jawal19/3D-printing-a-mechanical-device/Report/Images/Ramp/ramp_3.PNG

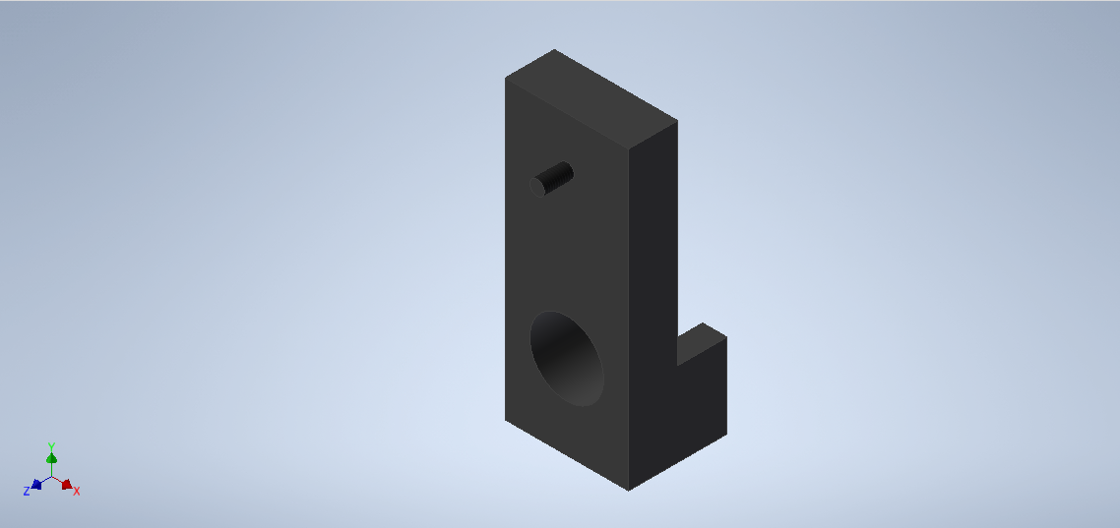
Report/Images/Ramp/ramp_3.PNG
