jawal19/3D-printing-a-mechanical-device/Report/Images/Ramp/ramp_1.PNG

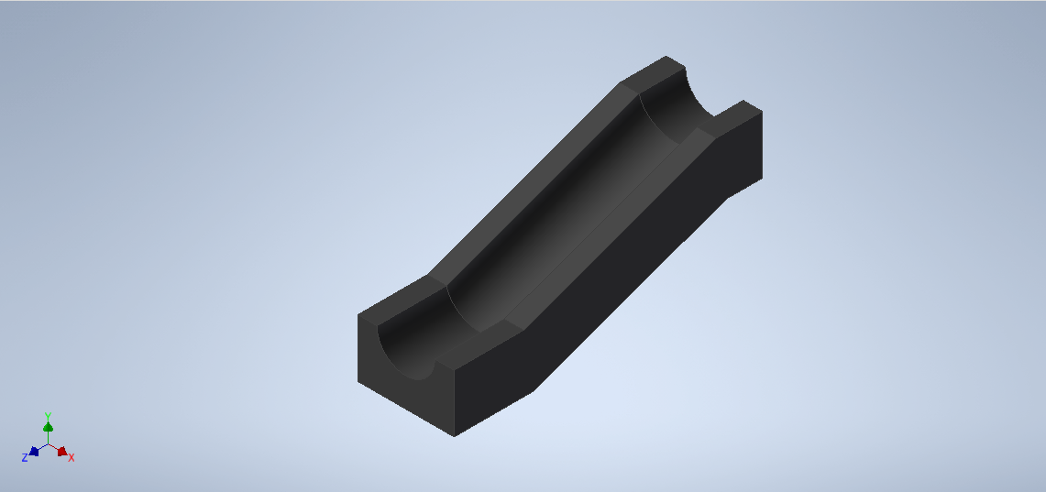
Report/Images/Ramp/ramp_1.PNG
