jawal19/3D-printing-a-mechanical-device/README.md

# Project-A
 Mechanical System transferring a steel ball
