jawal19/3D-printing-a-mechanical-device/Submision 1/Project A.pdf

# Project A

Jawal Trivedi & Nabeel Azafer

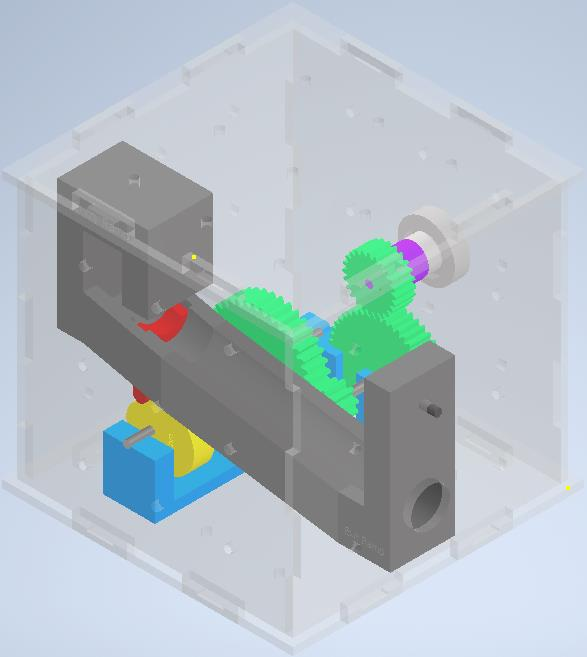
[picture p5: figure]

## Contents

Executive Summary | 3
Design Process | 3
Mechanism Specifications | 3
Shaft Rotational Speed | 3
Gear Ratio | 3
Bill of Materials | 3
Summary of Design Calculations | 6
Required Speed Output | 6
Compound Gear Train | 6
Summary of Analysis | 6
Dynamic Simulation 1 | 6
Dynamic Simulation 2 | 6
Summary of Prototype Manufacturing | 7
Justification of 3D Printing | 7
Design Decisions based on 3D Printing | 7
3D Printer Build Settings | 8
Print 1 | 8
Print 2 | 8
Print 3 | 8
Print 4 | 8
Decisions for Ease of Assembly | 8
Iterative Improvements | 8
Time Cost Analysis | 9
Conclusions | 9
Appendix | 10
Appendix A – Figures | 10
Appendix B – Calculations | 14
Appendix C – Statement of Contributions | 14
Appendix D – Tables | 15

## Executive Summary

Project A revolved around designing a mechanism with two mechanical elements which fits into a box of cubic volume 100mm³. The aim of the mechanisms is to transfer a steel ball of 9.5mm diameter from one end of the box to the other. The mechanical elements must convert an input rotation into the desired motion to drive the ball in exactly 5.0 seconds. Our team has iterated a solution which includes, support structures, a cam and follower mechanism and a compound gear train for the design problem (refer to Figure 5).

## Design Process

During the Project, our team mainly focused on the conceptual design and prototyping phases of the design process. The project was initialised with a close look at the specifications/requirements and creating a PDS. Thereafter we developed a product decomposition (refer to Figure 6) to break down the overall design problem. Referring to the decomposition, the next stage was to identify the two or more mechanical elements. We individually came up with two ideas each for the different combinations of elements and used those to develop a Pugh’s Matrix (refer to Table 3). Using this analysis tool, we decided on a cam & follower alongside a compound gear train. With a brief iteration back to the product decomposition, we discussed the type of support and collectively agreed that a ramp connecting the entry and exit holes would be best. Once the two elements and the support type were agreed on, we fixated on deciding the joining mechanisms. Initially we had thought of using the M3 series of nuts and bolts to fix our ramp, however later in the prototyping phase we made a judgement call and decided to use superglue. Similarly, in terms of joining the gears and shaft together we had planned to extrude the shaft out of the gear with a key, however, this was substituted by a steel rod and superglue during the prototyping phase.

## Mechanism Specifications

### Shaft Rotational Speed

The required shaft rotational speed is 60RPM. (Refer to Appendix B – Calculations for elaboration)

### Gear Ratio

The overall gear ratio of the compound gear train is 8:1. The ratio of each set of meshing gears is 1:2 and 1:4. (Refer to Appendix B – Calculations for elaboration)

### Bill of Materials

The Bill of Materials below excludes the parts provided by the University, e.g. the box sides and the driveshaft coupling.

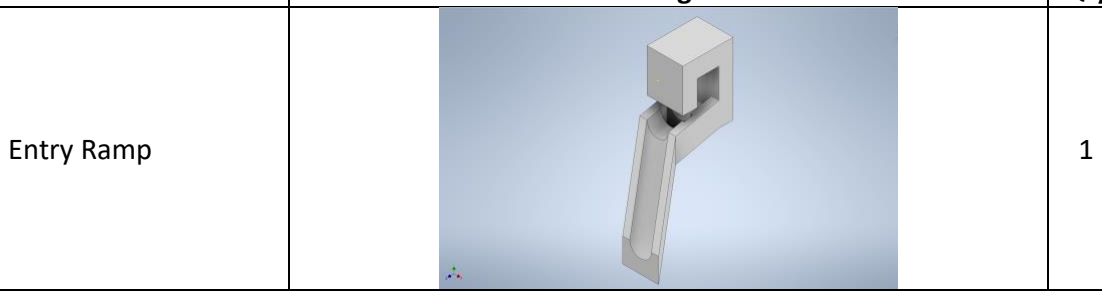
[picture p6: figure]
Entry Ramp

Part Name | Image | Qty

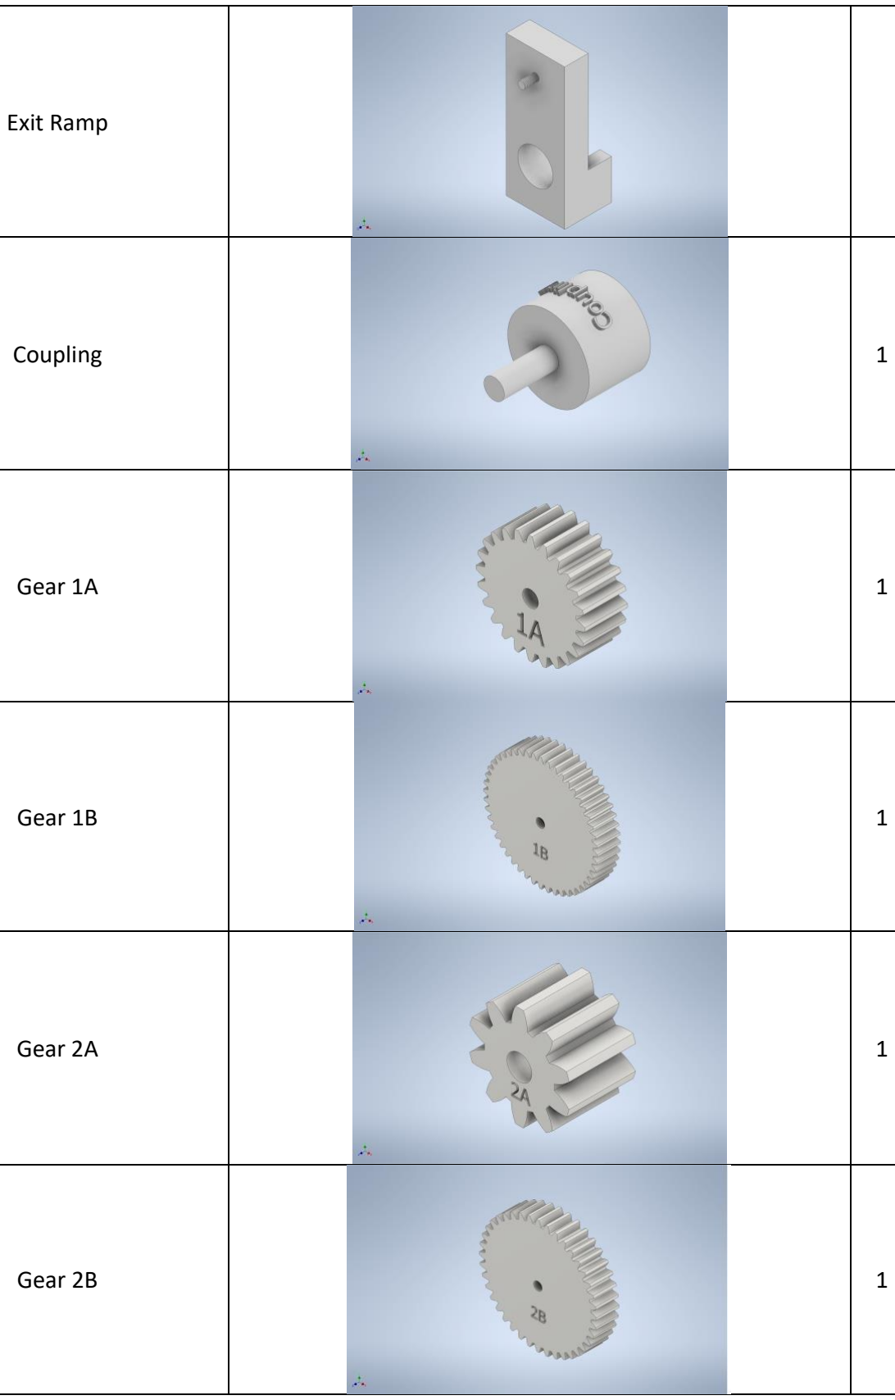
[picture p7: figure]
Exit Ramp; Coupling; Gear 1A; Gear 1B; Gear 2A; Gear 2B

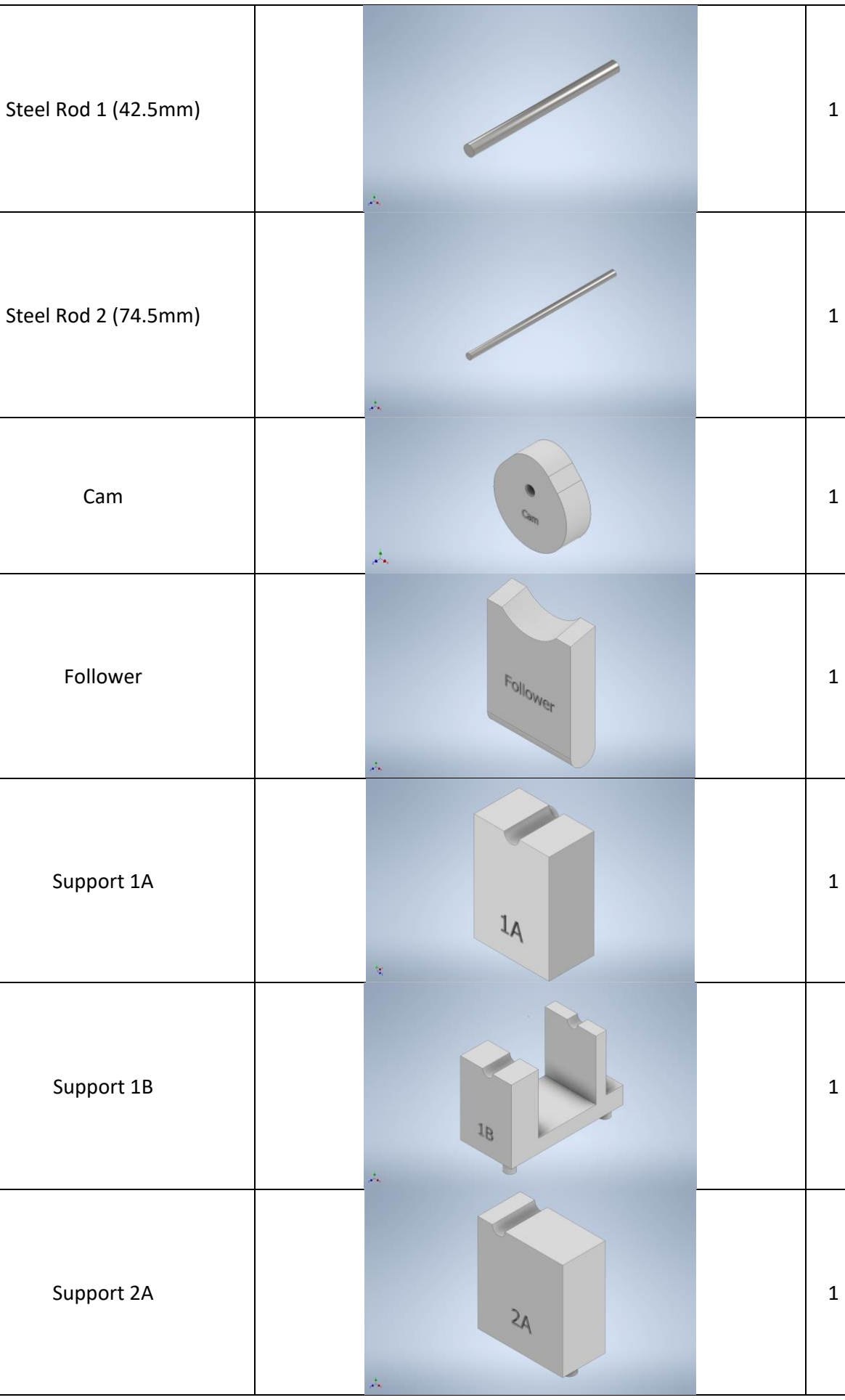
[picture p8: figure]
Steel Rod 1 (42.5mm); Steel Rod 2 (74.5mm); Cam; Follower; Support 1A; Support 1B; Support 2A

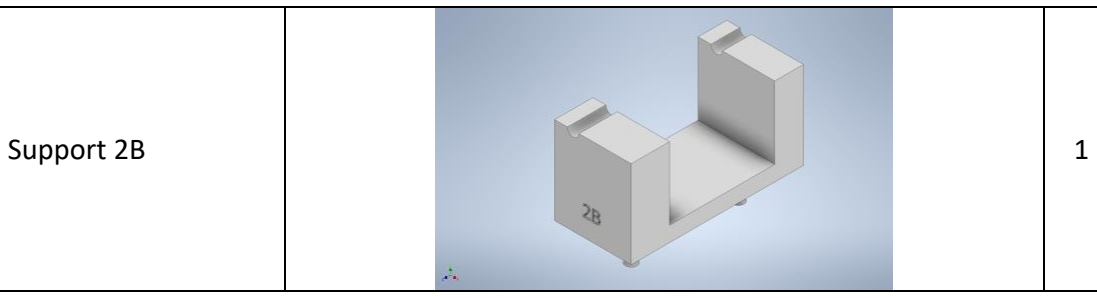
[picture p9: figure]
Support 2B

Table 1: Bill of Materials

## Summary of Design Calculations

### Required Speed Output

According to a dynamic simulation model (refer to Dynamic Simulation 1), it takes about, 0.3 seconds for the ball to come down the ramp. Therefore, the ball needs to be obstructed by the follower for about 4 seconds. If the dwell of the cam lasts for 180° and the input rotational speed is 60RPM, Calculation 1 shows the gear ratio comes to 8:1.

### Compound Gear Train

Calculation 2 shows the gear ration of each meshing gears in the compound gear train. If the overall ratio needs to be 8:1, then first set of meshing gears needs to have a ratio of 1:2, and the second set of meshing gears needs to have a ratio of 1:4.

## Summary of Analysis

### Dynamic Simulation 1

The first analysis was a dynamic simulation of the steel ball rolling down the ramp. This was carried out to extract the time taken for the ball to roll down the ramp. The simulation estimated around 0.3 seconds (refer to Figure 7). Figure 1 below shows the graph of the velocity of the ball (in mm/s) in the x-direction. As the ball moves in the negative x-direction the velocities shown are negative. From the analysis of the graph, our team decided to put the obstruction by follower when the velocity is relatively small so there won’t be too much deflection.

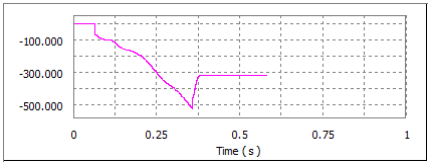
[picture p10: figure]

Figure 1: Graph of Velocity vs Time of ball in X-direction

### Dynamic Simulation 2

The second dynamic simulation was done to check whether our mechanism outputs the steel ball in the time predicted. The analysis showed that if the follower height was increased by 2mm, and the profile of the cam profile was reverted to the pear shape, the time taken is approximately 5.06 seconds which falls under the tolerance. Figure 2 below shows the coordinates of the ball in X (Blue), Y (Pink) and Z (Red) direction in mm, over time.

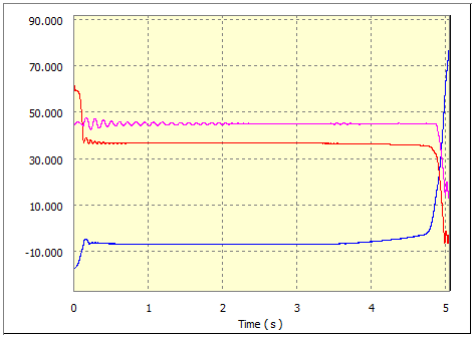
[picture p11: figure]

Figure 2: Graph of Coordinates in X,Y,Z-direction vs Time of the steel ball

## Summary of Prototype Manufacturing

### Justification of 3D Printing

Throughout this project we only used a 3D printer to print the parts. We decided against using a laser cutter because the only parts we could’ve laser cut were the gears due to the thickness limitations. Besides this, when we were up to the prototyping phase, we didn’t have enough time to use both, hence we only used the 3D printers throughout this project.

While using the 3D printers, we simultaneously printed our first two prints, and produced parts that were either incorrectly dimensioned (calculation error) or of poor quality (printer error). On our third attempt we were able to print the correct parts, however, during post-processing, we damaged the coupling to the drive shaft. Due to this and a few design changes after our analysis, we executed a fourth and final print.

### Design Decisions based on 3D Printing

A slot in the Entry Ramp was created for the follower to slide up and down in. This design decision was made knowing that we are 3D printing the part, otherwise it would have been too difficult to fabricate. We also decided not to have a roller on our follower as the curved edge from 3D printing would be able to compensate for it. The thickness of the parts created were purposely greater than 3mm, because of the limitations of the printers. Whilst designing the gears, the minimum pitch diameter our team considered was 10mm, again due to the fabrication limits of the 3D printer.

### 3D Printer Build Settings

Print 1
As we were inexperienced in 3D printing, we heavily relied on the guidelines provided. We used an Original Prusa Mini printer with a 0.4mm nozzle. We used 0.25mm layer height with variable layer height on adaptive at 0.5. We also added support material everywhere as we were uncomfortable deciding this manually. The build plate was arranged automatically according to the PrusaSlicer software (refer to Figure 8). The printer, however, was slightly faulty so Jonathan Stringer changed a few settings such as the nozzle temperature using the Expert mode in the software.

Print 2
The second print was also on an Original Prusa Mini (0.4mm nozzle. On this print however, we used a general layer height of 0.20mm for a better quality with adaptive in variable layer height with preference to quality (0.3). Again, we added supports everywhere as this print had an overhang used the arrange function to automatically arrange the parts onto the bed (refer to Figure 9).

Print 3
We were able to use an Original Prusa i3 MK2S (0.4mm nozzle) on our third attempt. The general layer height selected was 0.35mm, with variable layer height selected on adaptive at 0.5. Supports were added everywhere, and the arrange function was again used to automatically set the parts on the bed (refer to Figure 10).

Print 4
We used the Original Prusa i3 MK2S (0.4mm nozzle) in the final print. A general layer of 0.35mm was selected with variable layer height on at 0.5. Supports were added everywhere and the plate was arranged automatically (refer to Figure 11).

### Decisions for Ease of Assembly

Our original print had keys/keyways and a shaft extruded on; however, both were excluded from the final assembly. The keys/keyway were pointless due to the dimensional accuracy of the 3D Printers. We excluded the shaft extrusion because as we were snipping off the support material on the gears, we accidentally ripped of part of the shaft which would’ve been catastrophic if that happened during testing. In replacement of these two features we settled on using the 3mm steel shaft superglued to the gears and cam.

### Iterative Improvements

As shown in Figure 3 below the Ramp went through an iterative design process which improved its functionality over the process. The second iteration shows an input similar to a hook, this was added to account for a high input velocity of the ball, which made the design more robust. The combination of the first two designs is shown in the third iteration. The fourth and fifth iteration shows, a slot for the follower was implemented and the exit ramp improved such that it connects to the exit hole rather than hanging freely. The fifth image shows the entry and exit ramps in conjunction, which was used in the final assembly.

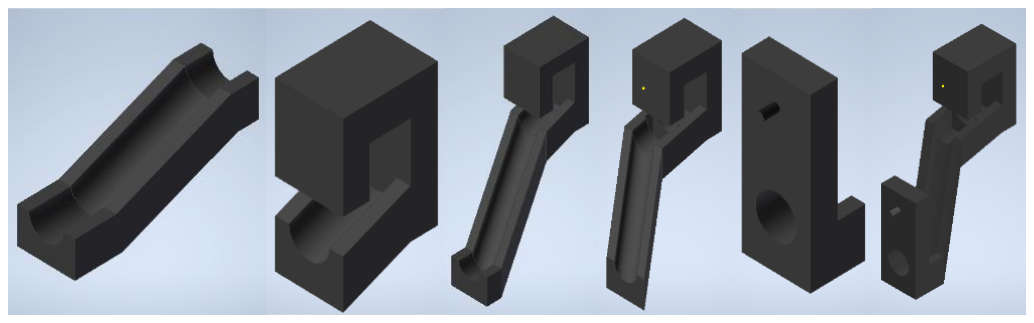
[picture p12: figure]

Figure 3: Design improvements of the Ramp

In Figure 4 the design improvements of the cam. The profile of the cam was changed in all successions. The second iteration the profile was changed from a snail shape to a pear shape as there was a significant drop, which would apply unnecessary force onto the shaft. The third iteration was created as there was limited space and the previous profile was obstructing part the ramp. A keyway was also added in this occurrence to drive the shaft more smoothly. The fourth succession was created because an unnecessary dwell and rise was noticed in the behaviour of the follower. The fifth iteration was created after the analysis showed that this pear-shaped profile achieves the closest time to 5.0 seconds. Therefore, the bump at the top of the third cam was levelled out the location of the input was changed to improve the previous instalment.

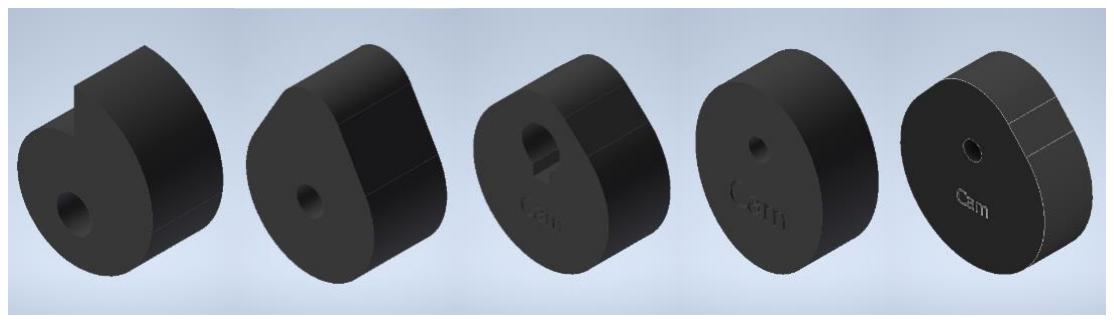
[picture p13: figure]

Figure 4: Deign improvements of the Cam

### Time Cost Analysis

Category | 3D Printing
Material | 105.39g at $50/kg $5.30
Energy | 7.6 hours & 50W at $0.2/kWh $0.077
Labour | ~2 hours @ $30/hr $60
Total Time | 9.6 hours (9hr 40min)
Total Cost | $65.40
Table 2: Time Cost Analysis

## Conclusions

Throughout Project A, we learned a lot about Prototype Manufacturing, more specifically using 3D Printing. The solution we derived included a ramp for the ball to roll down, a follower driven by a cam to obstruct and delay the ball, and a gear train to time and drive the cam. Alongside the main elements, we created support structures and couplings for the gear and input shaft respectively. To join the gears, we utilised the 3mm steel rod and superglue. The overall mechanism converts rotational motion by the input to linear motion produced by the follower. Using analysis tools such as dynamic simulation we were able to predict that our mechanism meets the required time of 5.0 seconds. Refer to Figure 12 to Figure 15 for a visual interpretation of our design.

## Appendix

### Appendix A – Figures

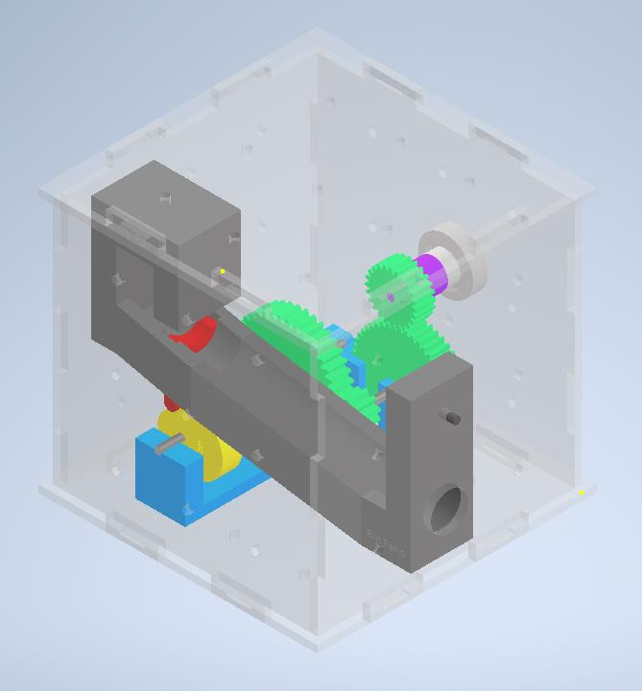
[picture p14: figure]

Figure 5: Final Assembly

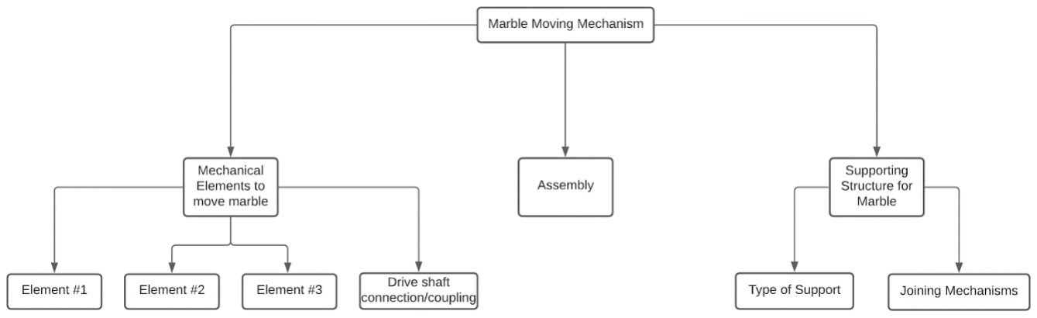
[picture p15: figure]

Figure 6: Product Decomposition

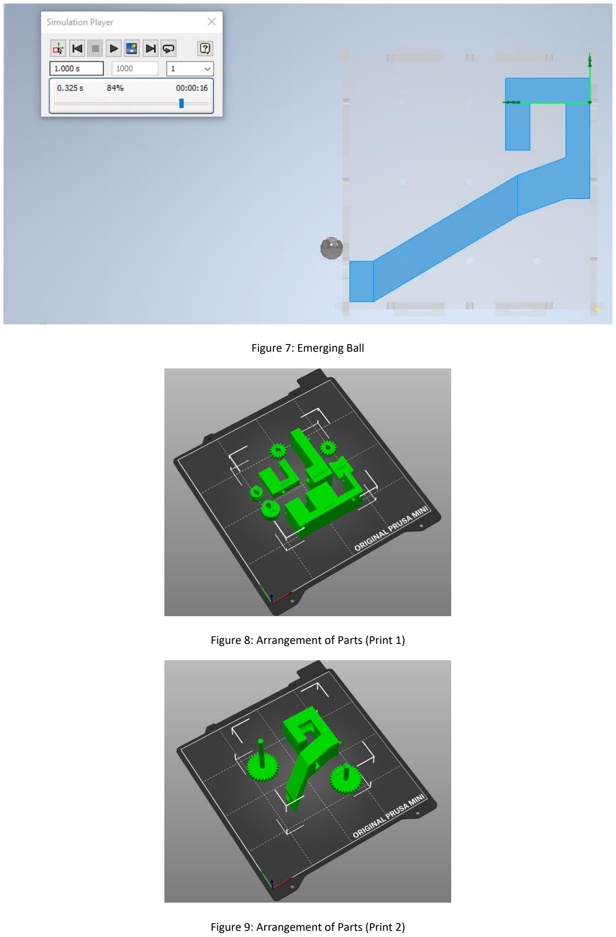
[picture p16: page 11]

Figure 7: Emerging Ball

Figure 8: Arrangement of Parts (Print 1)

Figure 9: Arrangement of Parts (Print 2)

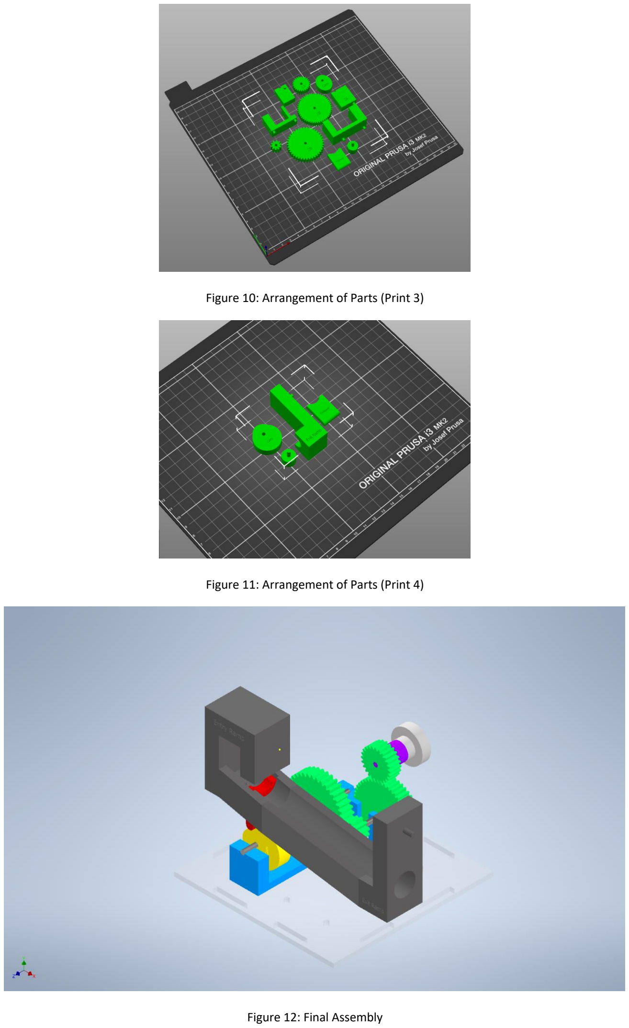
[picture p17: page 12]

Figure 10: Arrangement of Parts (Print 3)

Figure 11: Arrangement of Parts (Print 4)

Figure 12: Final Assembly

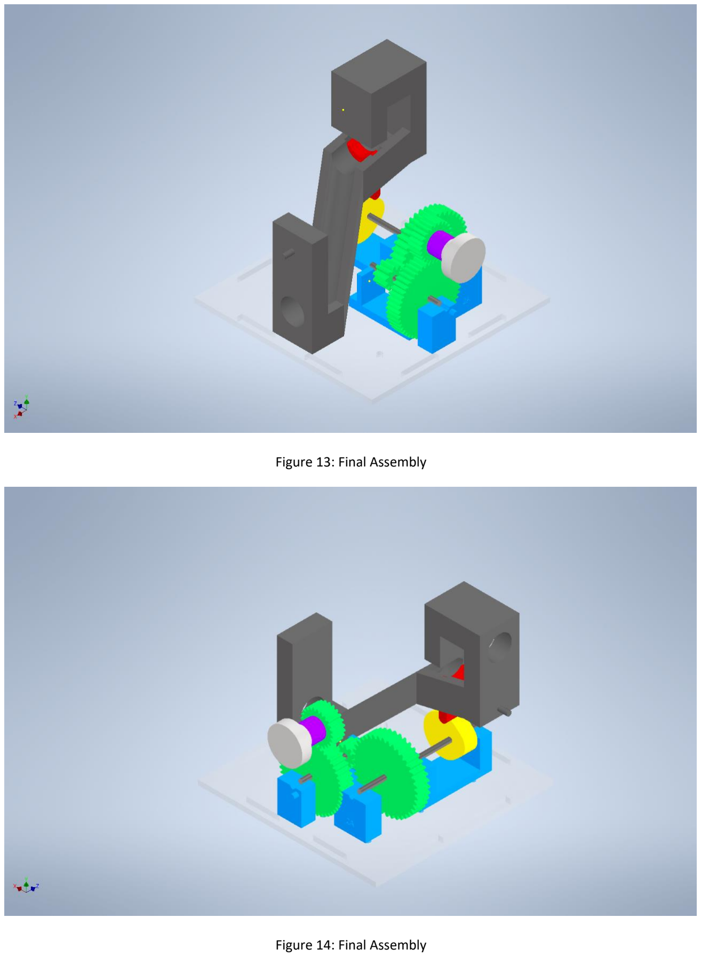
[picture p18: page 13]

Figure 13: Final Assembly

Figure 14: Final Assembly

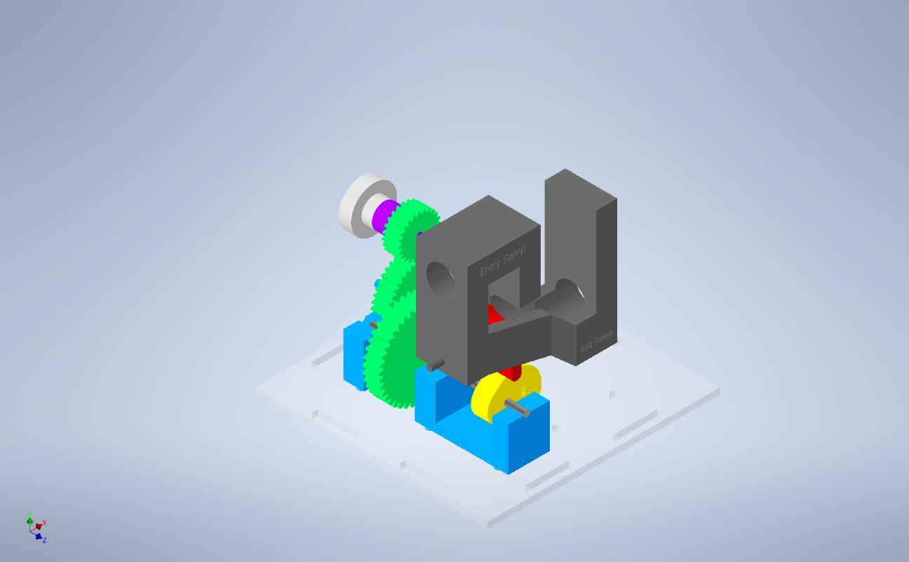
[picture p19: figure]

Figure 15: Final Assembly

### Appendix B – Calculations

180 deg
4 sec

=

45 deg
sec
∴

45 deg
sec

×

1 rev
360 deg ×

60 sec
1 min
= 7.5 RPM
So tℎe overall gear ratio will be 60: 7.5 or 8: 1

1

ωinput

ωoutput

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
### Appendix C – Statement of Contributions

Category | Jawal | Nabeel
PDS | 50% | 50%
Product Decomposition | 50% | 50%
Pugh’s Matrix | 50% | 50%
Calculations | 60% | 40%
CAD Model | 40% | 60%
Dynamic Simulation | 40% | 60%
3D Printing & Assembly | 50% | 50%

### Appendix D – Tables

Categories | Straight-line linkage with cam | Scooping sliding mechanism | Gear trains with cam | Gear Train with sliding crank
Accuracy | Can accurately move the marble vertically N/A | May not be able to accurately pick up the ball -VE | Could be precise once we have the correct timing on the cams EQUAL | Would be accurate as we just need to do the sliding crank calculations. EQUAL
Robustness | Since the cam element will block the ball variations in ball input velocity won’t have a major impact N/A | Differing ball input velocities may result in different outcomes -VE | Could be an issue with a high-velocity input of the ball -1 | Quite robust because, as the marble is inputted its motion instantly changes. +VE
Ease of Assembly | 4 bar linkage mechanism may be difficult to assemble, due to multiple joints N/A | Relatively simple assembly +VE | Cam mechanism could be complicated to assemble. +VE | The sliding crank would be difficult to assemble -VE
Ease of Manufacturing | Will likely have to 3d print joints individually which can take time N/A | Not many components to print, but the sliding mechanism will take time to print EQUAL | Many different components to print, so could take a while EQUAL | Not too complicated to print with a 3D printer. EQUAL
Design Simplicity | The cam element is simple, the linkage is slightly more complex N/A | The sliding element will likely be very complex to design and implement -VE | Quite a simple design as it only has two easy to understand mechanisms +VE | A complicated design due to the positioning of the two mechanical elements +VE
Number of Moving parts | Quite a few moving parts like joints, gears etc N/A | Only a few moving parts +VE | Various moving parts includes gear train and cams. Will also needs multiple bearings. +VE | Not that many moving parts, only gears, crank, conrod and slider. +VE

Overall | N/A

1

3

2

Table

3: Pugh’s Matrix
