jawal19/3D-printing-a-mechanical-device/Report/Images/Cam/Cam_1.PNG

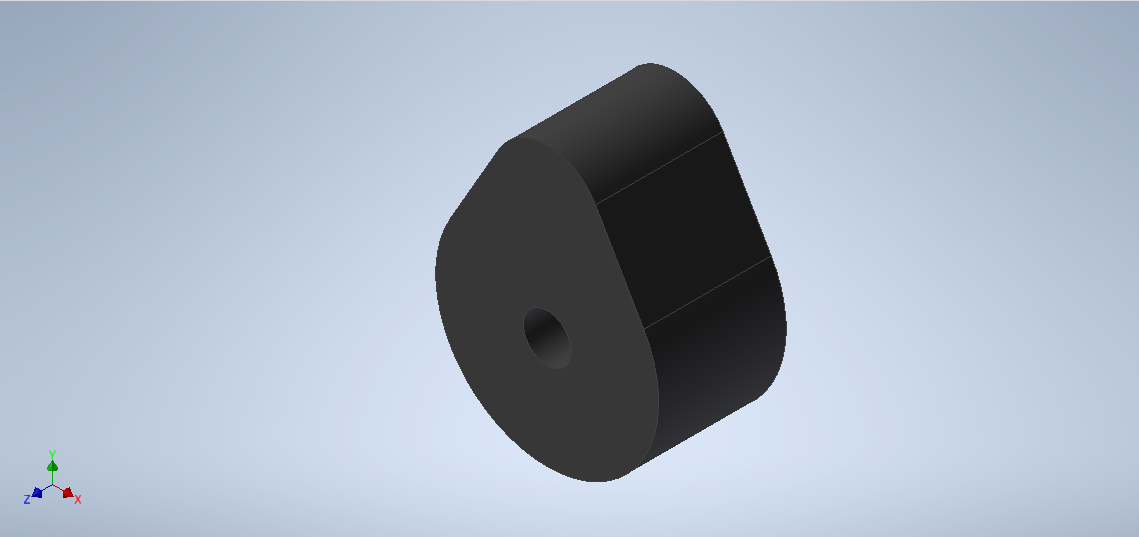
Report/Images/Cam/Cam_1.PNG
