jawal19/3D-printing-a-mechanical-device/Report/Images/Cam/Cam_3.PNG

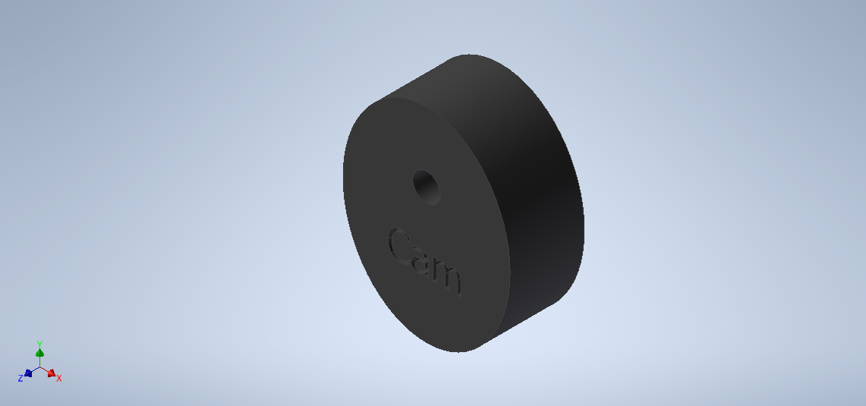
Report/Images/Cam/Cam_3.PNG
