jawal19/3D-printing-a-mechanical-device/Report/Images/Cam/Cam_4.PNG

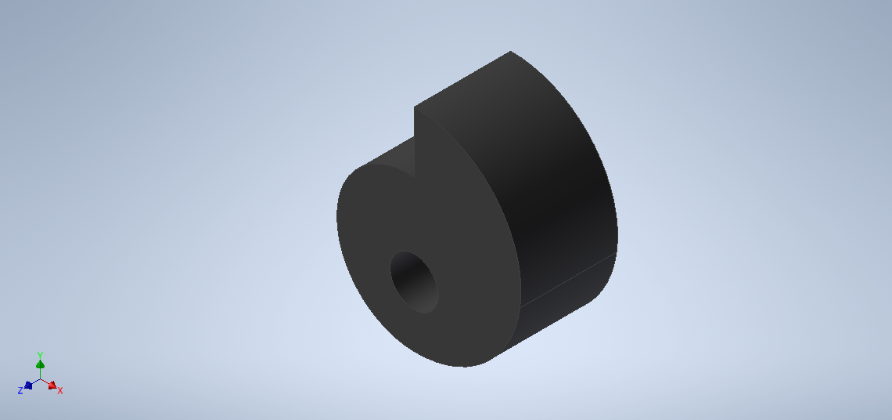
Report/Images/Cam/Cam_4.PNG
