jawal19/3D-printing-a-mechanical-device/Report/Images/Dynamic Sim/emerging ball.PNG

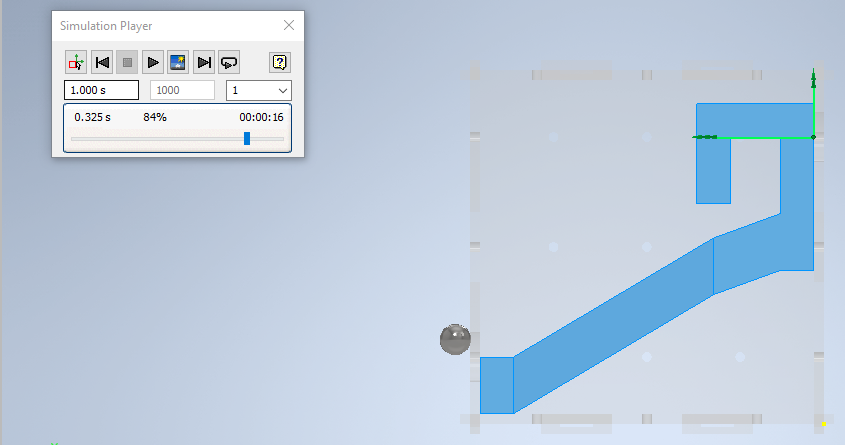
Report/Images/Dynamic Sim/emerging ball.PNG
