jawal19/3D-printing-a-mechanical-device/Report/Images/Dynamic Sim/sim_2_graph.PNG

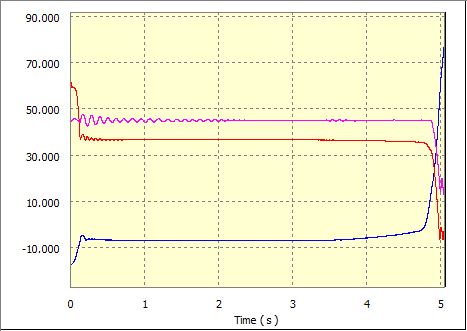
Report/Images/Dynamic Sim/sim_2_graph.PNG
