jawal19/3D-printing-a-mechanical-device/Report/Images/Ramp/ramp_5.PNG

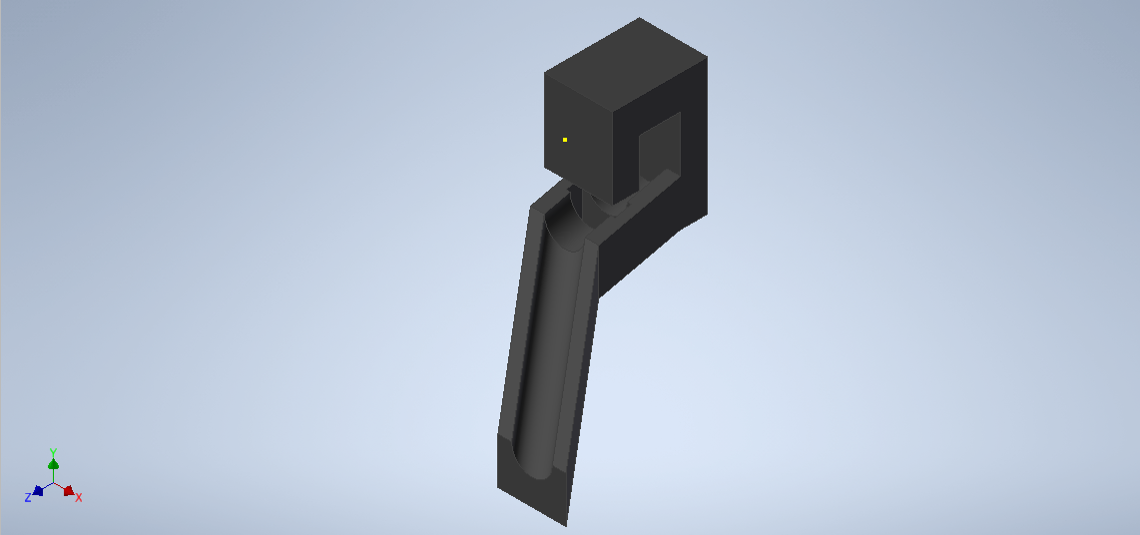
Report/Images/Ramp/ramp_5.PNG
