jawal19/3D-printing-a-mechanical-device/Report/Images/Ramp/ramp_7.PNG

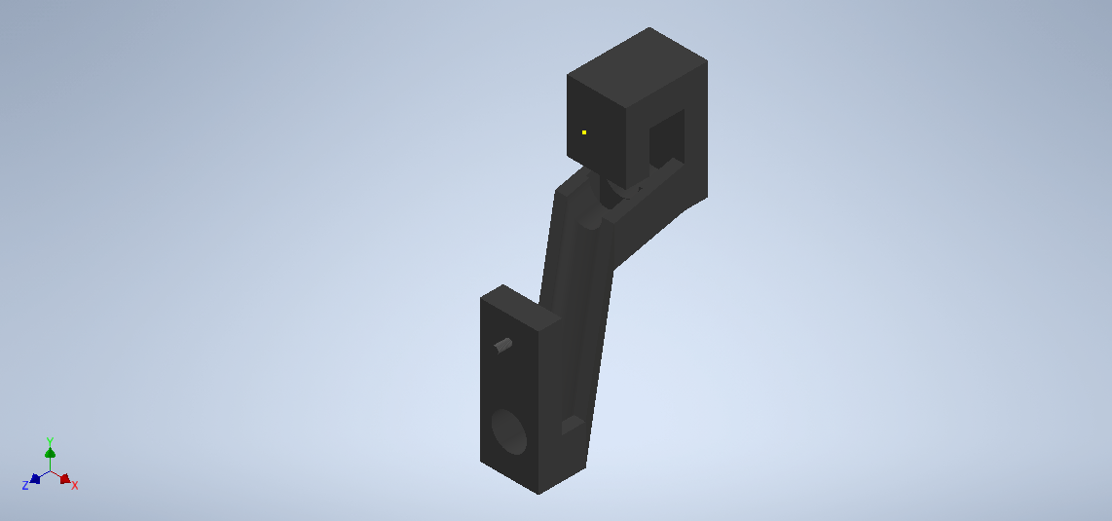
Report/Images/Ramp/ramp_7.PNG
