jawal19/3D-printing-a-mechanical-device/CAD Files/PrusaSlicer/TCA/Assembly_for_TCA.stl

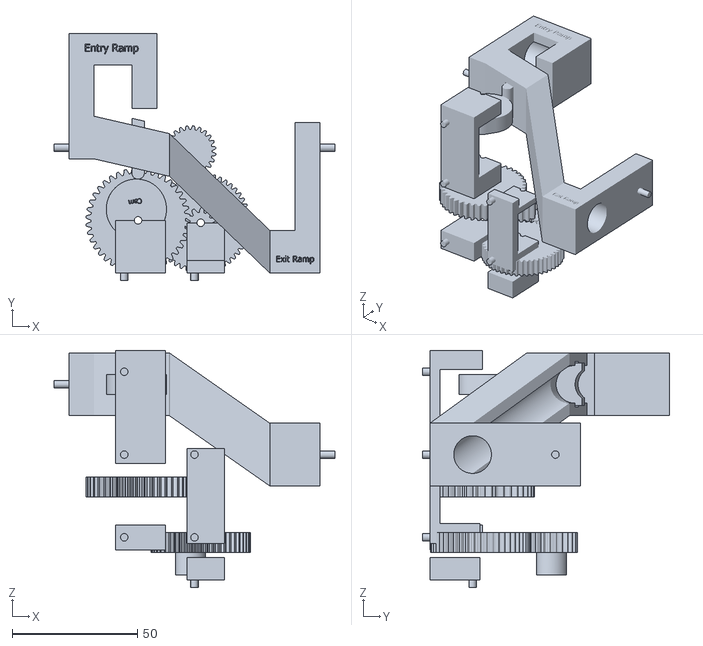
[picture p29: CAD file, 2021-07-16]
CAD Files/PrusaSlicer/TCA/Assembly_for_TCA.stl
112.0 x 98.5 x 94.5
