jawal19/3D-printing-a-mechanical-device/CAD Files/PrusaSlicer/Print 1/exit_ramp.stl

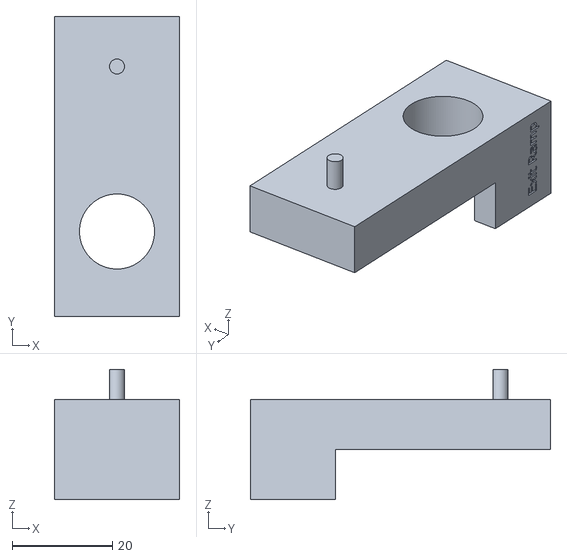
[picture p30: CAD file, 2021-07-16]
CAD Files/PrusaSlicer/Print 1/exit_ramp.stl
25.0 x 60.0 x 26.0
