jawal19/3D-printing-a-mechanical-device/CAD Files/PrusaSlicer/Print 2/Gear_2A.stl

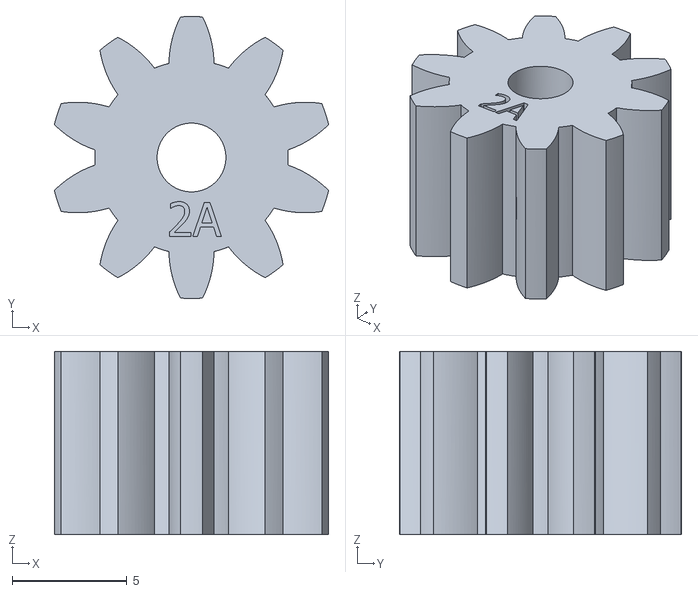
[picture p31: CAD file, 2021-07-16]
CAD Files/PrusaSlicer/Print 2/Gear_2A.stl
12.0 x 12.3 x 8.00
