jawal19/3D-printing-a-mechanical-device/CAD Files/PrusaSlicer/Print 4/Follower.stl

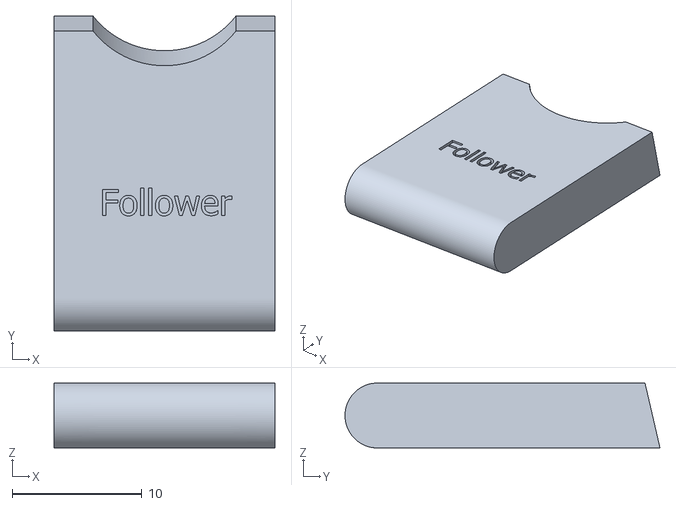
[picture p32: CAD file, 2021-07-16]
CAD Files/PrusaSlicer/Print 4/Follower.stl
17.0 x 24.2 x 5.00
