jawal19/3D-printing-a-mechanical-device/Submision 1/group14_Print_2 (1).3mf

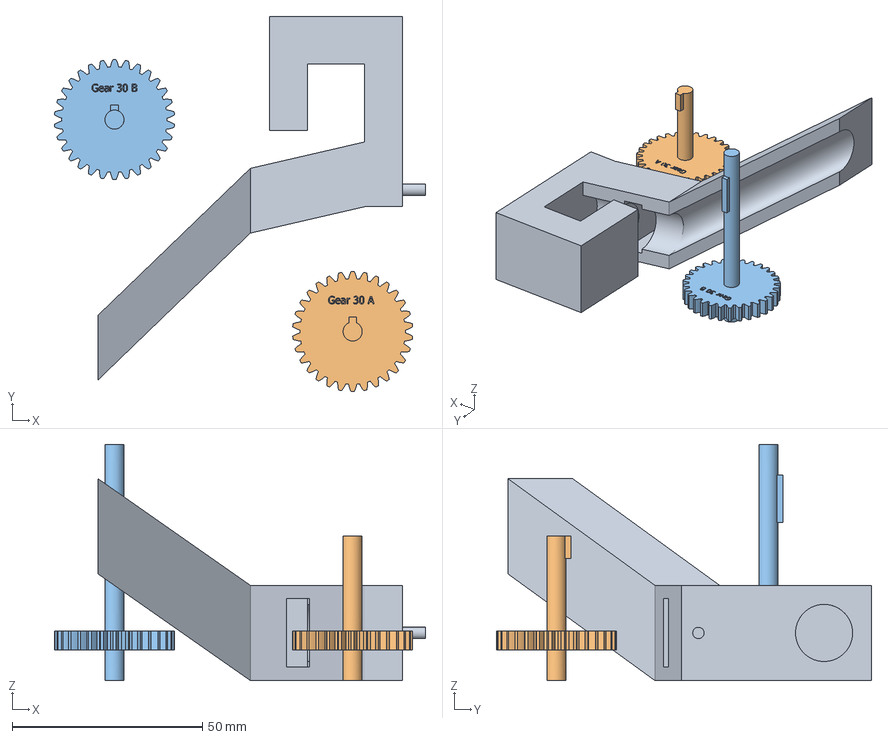
[picture p33: CAD file, 2021-07-16]
Submision 1/group14_Print_2 (1).3mf
97.4 x 98.6 x 62.0 mm
entry_ramp.stl
Final Spur Gear Large.stl
Final Spur Gear Large B.stl
