jawal19/3D-printing-a-mechanical-device/CAD Files/PrusaSlicer/Print 1/shaft_support A.stl

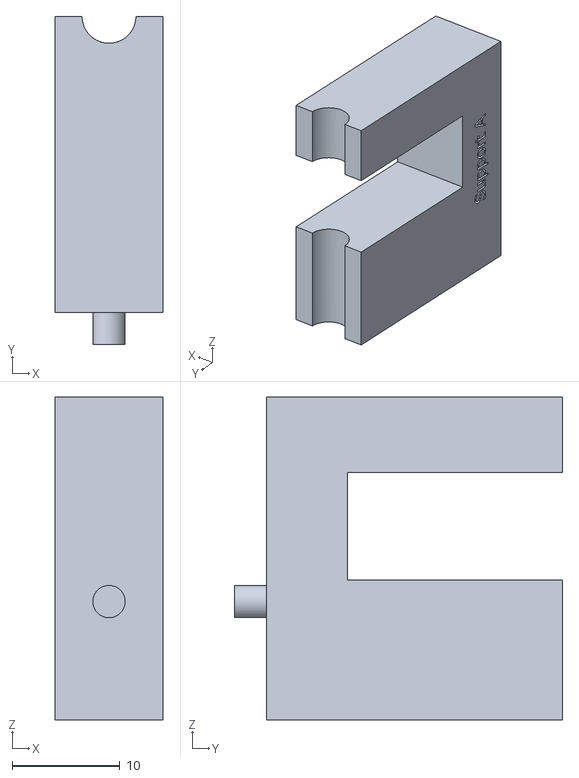
[picture p34: CAD file, 2021-07-16]
CAD Files/PrusaSlicer/Print 1/shaft_support A.stl
10.0 x 30.5 x 30.0
