jawal19/3D-printing-a-mechanical-device/CAD Files/PrusaSlicer/Print 2/Coupling.stl

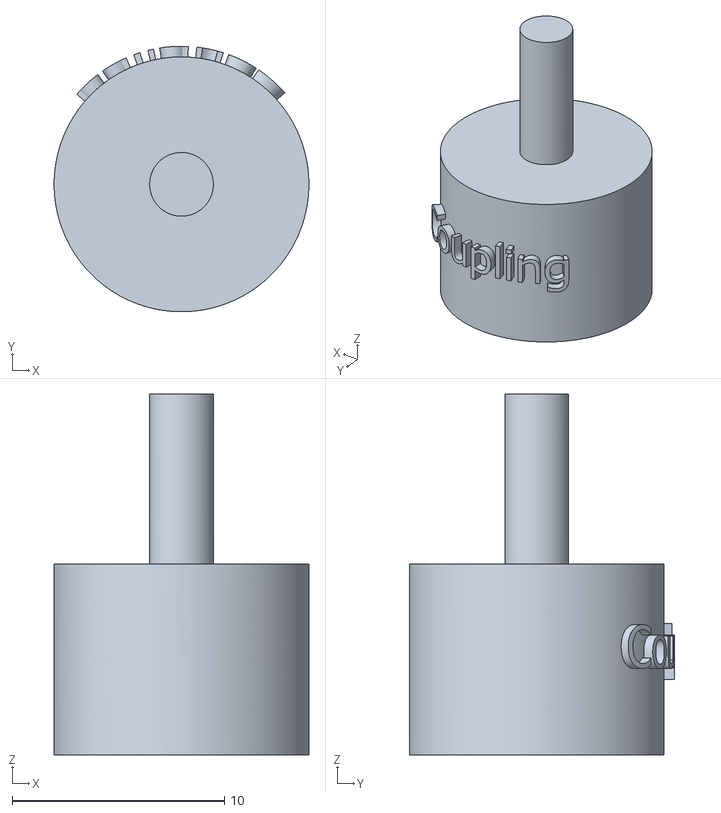
[picture p35: CAD file, 2021-07-16]
CAD Files/PrusaSlicer/Print 2/Coupling.stl
12.0 x 12.5 x 17.0
