jawal19/3D-printing-a-mechanical-device/CAD Files/PrusaSlicer/Print 4/Cam.stl

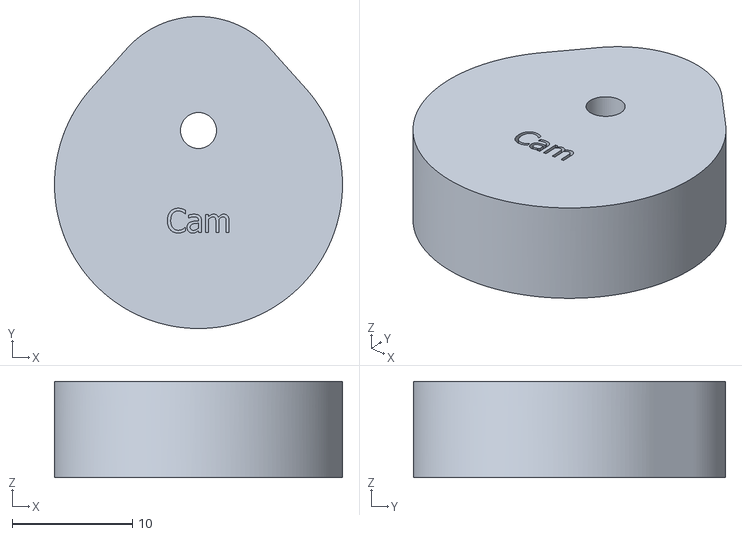
[picture p36: CAD file, 2021-07-16]
CAD Files/PrusaSlicer/Print 4/Cam.stl
24.0 x 26.0 x 8.00
