jawal19/3D-printing-a-mechanical-device/Submision 1/Cam,follower,ramp (1).3mf

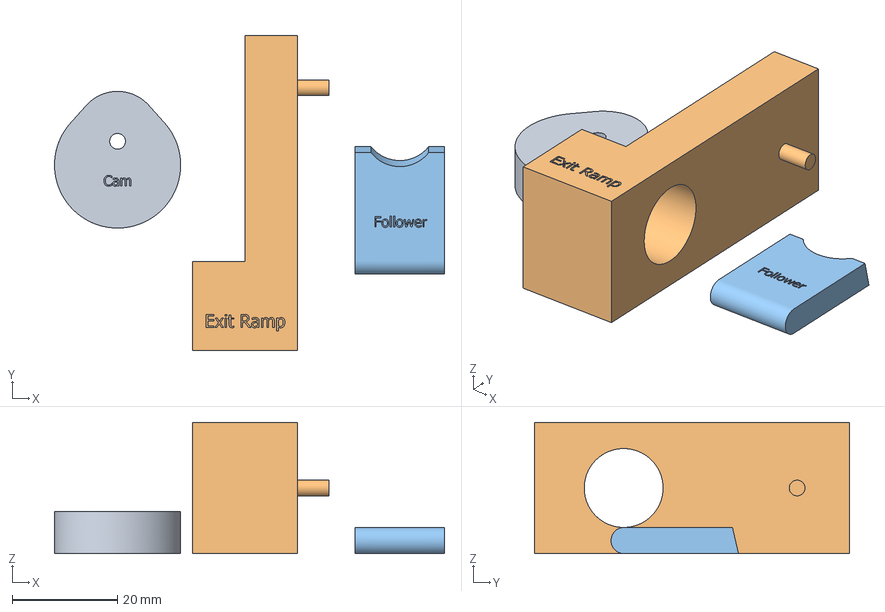
[picture p37: CAD file, 2021-07-16]
Submision 1/Cam,follower,ramp (1).3mf
74.2 x 60.0 x 25.0 mm
Cam.stl
Exit_Ramp.stl
Follower.stl
