jawal19/3D-printing-a-mechanical-device/CAD Files/PrusaSlicer/Print 1/Final Spur Gear Large B.stl

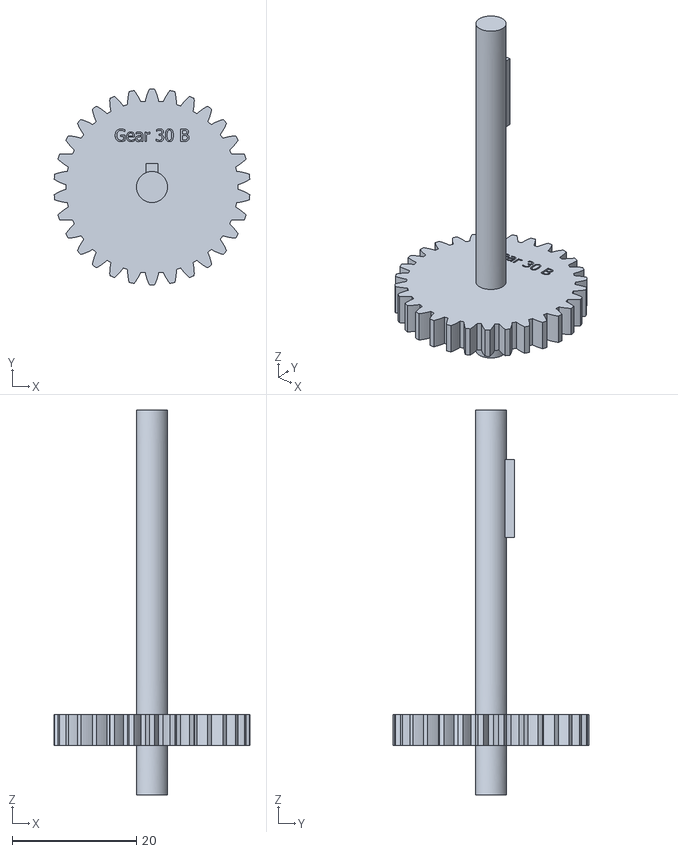
[picture p38: CAD file, 2021-07-16]
CAD Files/PrusaSlicer/Print 1/Final Spur Gear Large B.stl
31.5 x 31.6 x 62.0
