jawal19/3D-printing-a-mechanical-device/Submision 1/print_2 (2).3mf

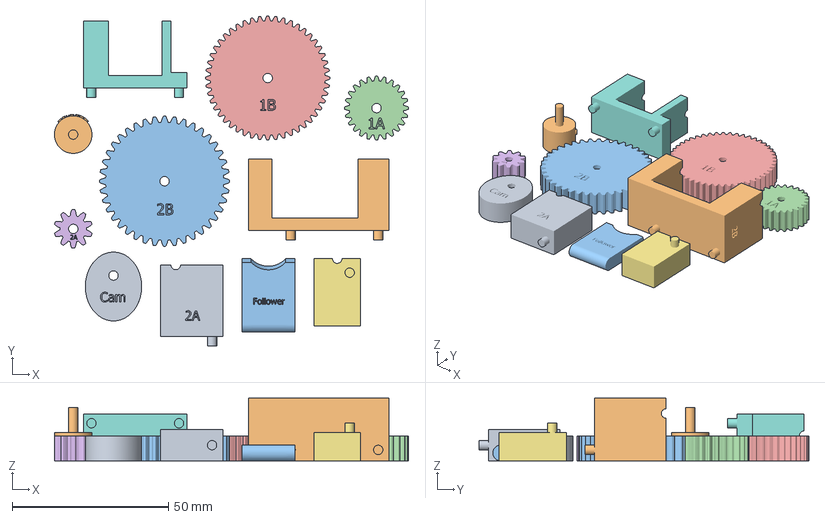
[picture p39: CAD file, 2021-07-16]
Submision 1/print_2 (2).3mf
113.2 x 105.5 x 20.0 mm
Cam.stl
Coupling.stl
Follower.stl
Gear_1A.stl
Gear_1B.stl
Gear_2A.stl
Support_1A.stl
Support_1B.stl
Support_2A.stl
Support_2B.stl
Gear_2B.stl
