jawal19/3D-printing-a-mechanical-device/CAD Files/PrusaSlicer/Print 1/shaft_support B.stl

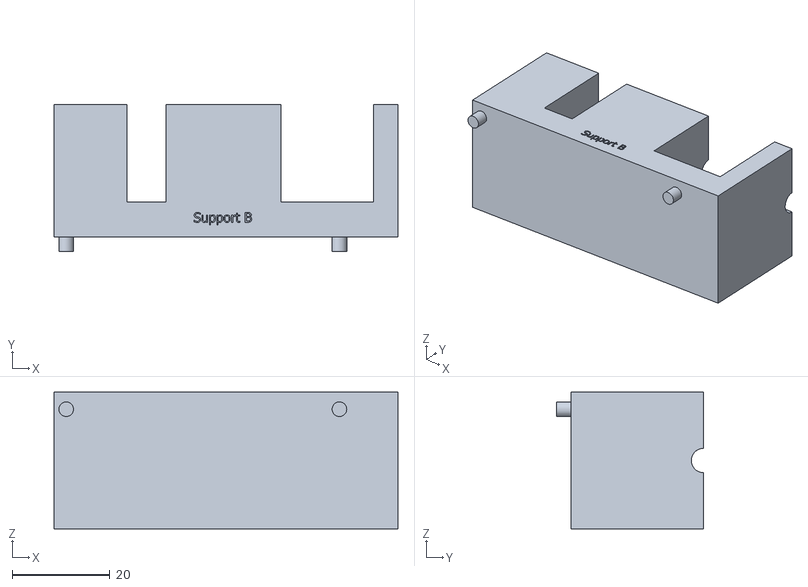
[picture p40: CAD file, 2021-07-16]
CAD Files/PrusaSlicer/Print 1/shaft_support B.stl
70.5 x 30.1 x 28.0
