jawal19/3D-printing-a-mechanical-device/CAD Files/PrusaSlicer/Print 2/Gear_1B.stl

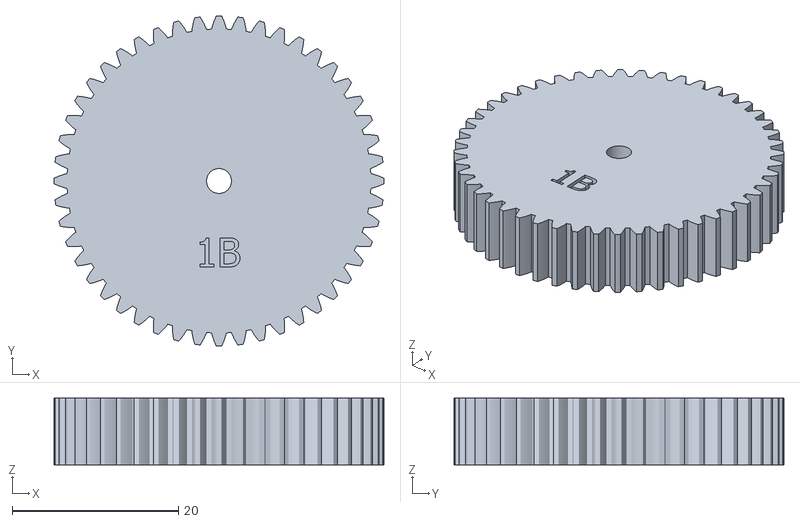
[picture p41: CAD file, 2021-07-16]
CAD Files/PrusaSlicer/Print 2/Gear_1B.stl
39.7 x 39.7 x 8.00
