jawal19/3D-printing-a-mechanical-device/Submision 1/group14_Print_1 (1).3mf

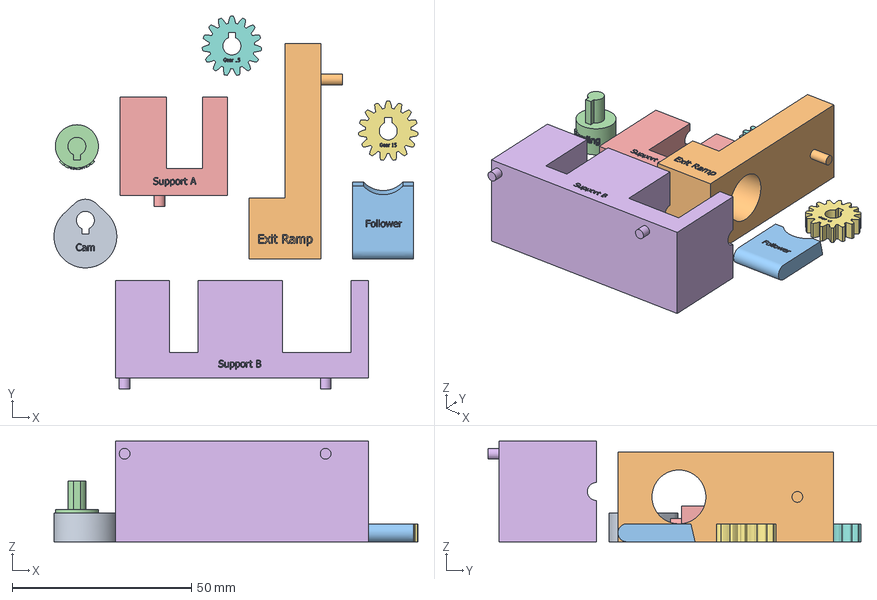
[picture p42: CAD file, 2021-07-16]
Submision 1/group14_Print_1 (1).3mf
101.4 x 103.8 x 28.0 mm
Cam.stl
exit_ramp.stl
Follower.stl
Input Connection.stl
shaft_support A.stl
shaft_support B.stl
Final Spur Small (Gear15).stl x 2
