jawal19/3D-printing-a-mechanical-device/CAD Files/PrusaSlicer/Print 1/Final Spur Gear Large.stl

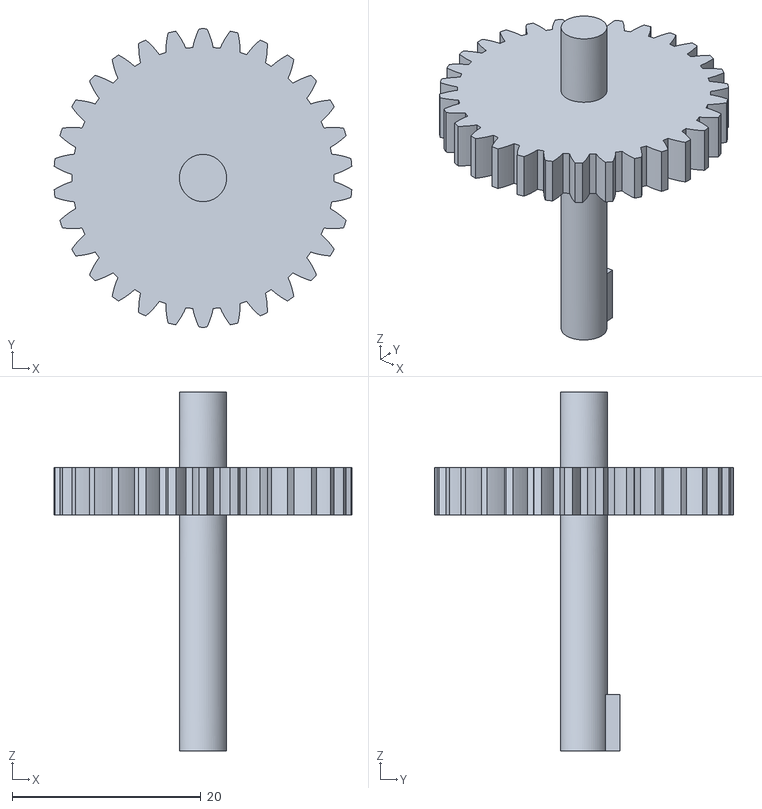
[picture p43: CAD file, 2021-07-16]
CAD Files/PrusaSlicer/Print 1/Final Spur Gear Large.stl
31.5 x 31.6 x 38.0
