jawal19/3D-printing-a-mechanical-device/CAD Files/PrusaSlicer/Print 2/Cam.stl

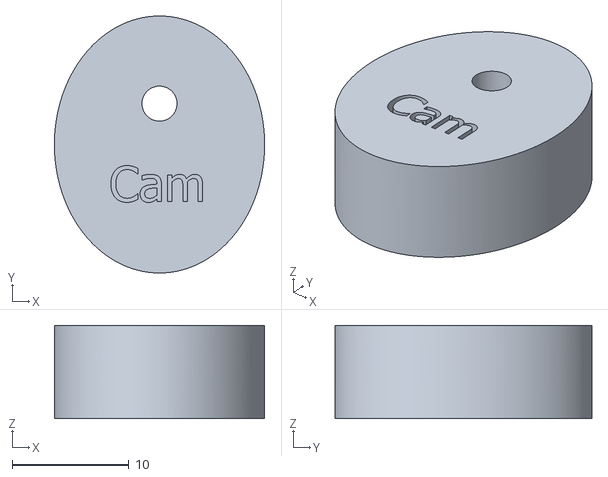
[picture p44: CAD file, 2021-07-16]
CAD Files/PrusaSlicer/Print 2/Cam.stl
18.0 x 22.0 x 8.00
