jawal19/3D-printing-a-mechanical-device/CAD Files/PrusaSlicer/Print 2/Support_2B.stl

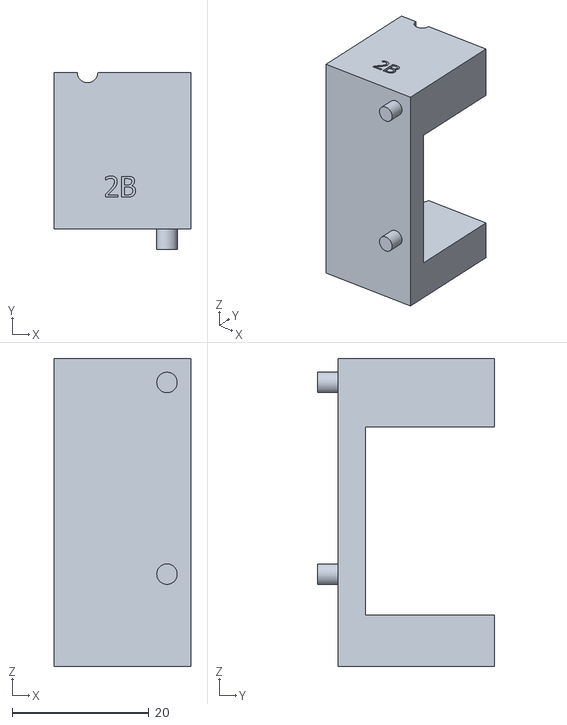
[picture p46: CAD file, 2021-07-16]
CAD Files/PrusaSlicer/Print 2/Support_2B.stl
20.0 x 25.9 x 45.0
