jawal19/3D-printing-a-mechanical-device/CAD Files/PrusaSlicer/Print 1/Cam.stl

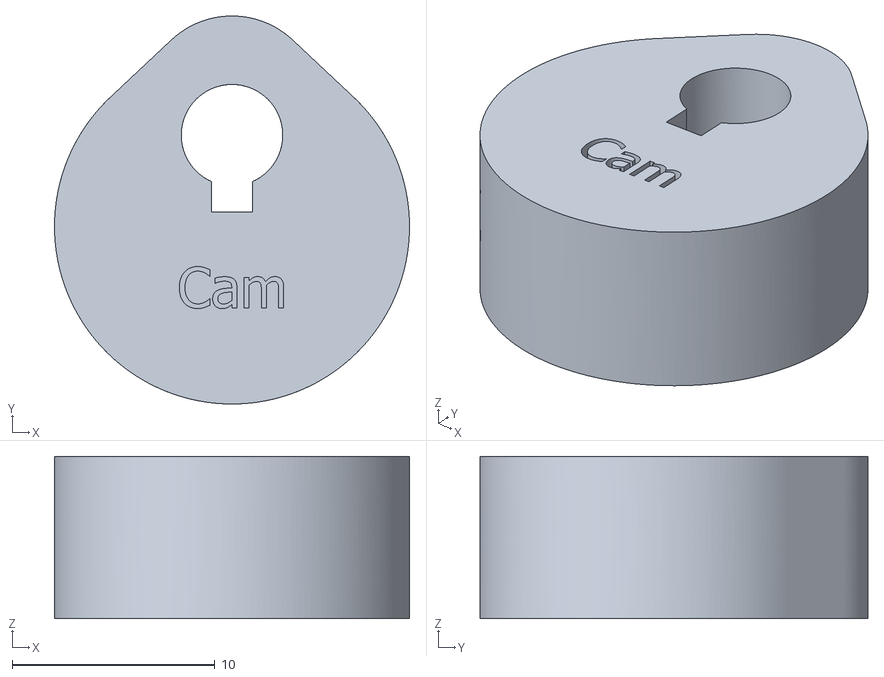
[picture p47: CAD file, 2021-07-16]
CAD Files/PrusaSlicer/Print 1/Cam.stl
17.5 x 19.1 x 8.00
