jawal19/3D-printing-a-mechanical-device/CAD Files/PrusaSlicer/Print 2/Support_2A.stl

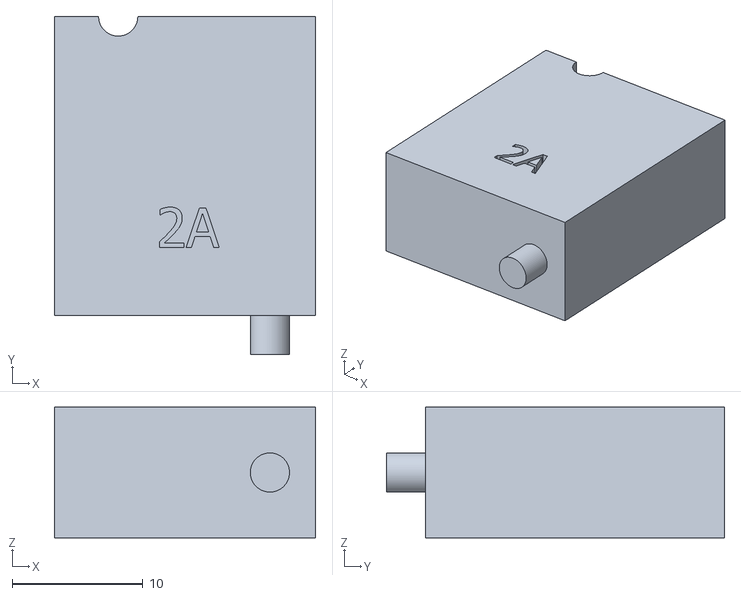
[picture p48: CAD file, 2021-07-16]
CAD Files/PrusaSlicer/Print 2/Support_2A.stl
20.0 x 25.9 x 10.0
