jawal19/3D-printing-a-mechanical-device/CAD Files/PrusaSlicer/Print 1/Final Spur Small (Gear15).stl

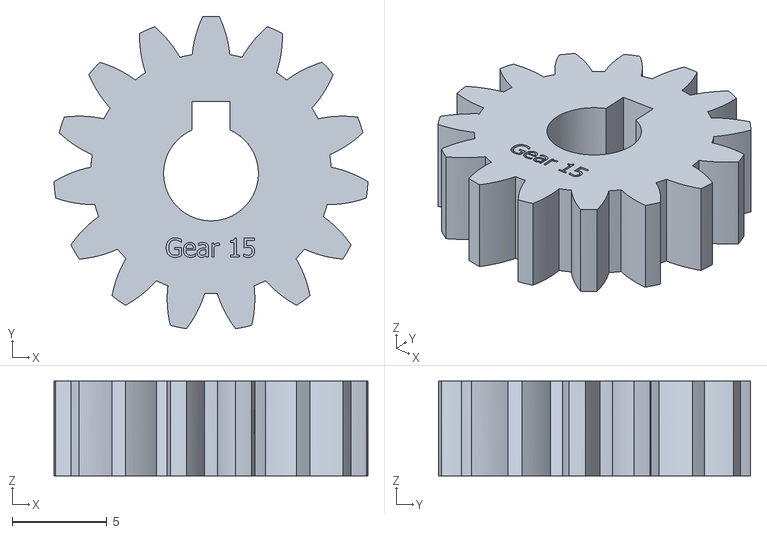
[picture p49: CAD file, 2021-07-16]
CAD Files/PrusaSlicer/Print 1/Final Spur Small (Gear15).stl
16.6 x 16.5 x 5.00
