jawal19/3D-printing-a-mechanical-device/CAD Files/PrusaSlicer/Print 2/Support_1A.stl

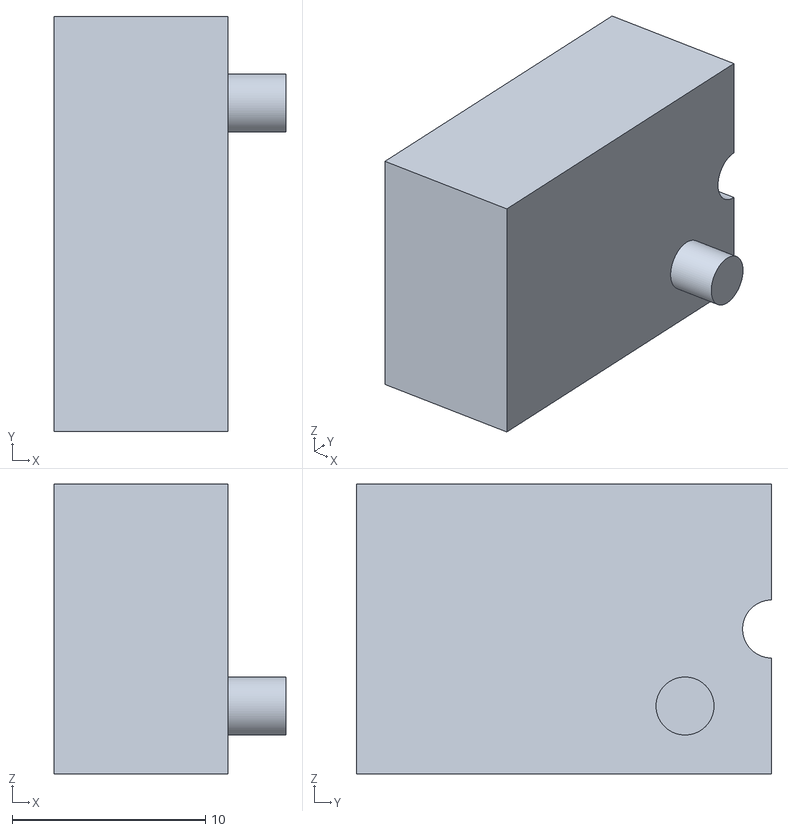
[picture p50: CAD file, 2021-07-16]
CAD Files/PrusaSlicer/Print 2/Support_1A.stl
12.0 x 21.5 x 15.0
