jawal19/3D-printing-a-mechanical-device/CAD Files/PrusaSlicer/Print 1/entry_ramp.stl

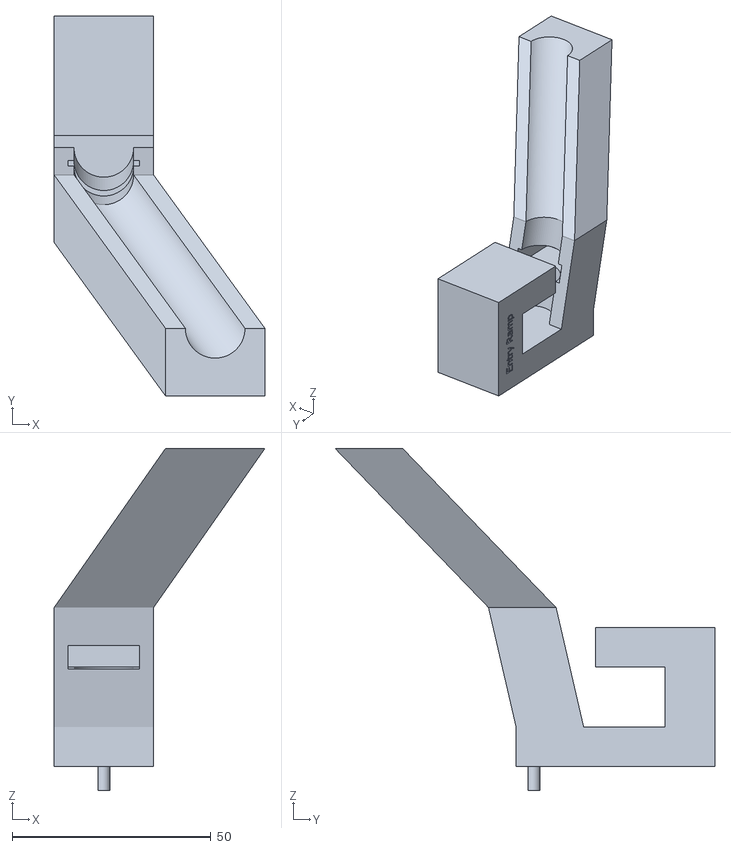
[picture p51: CAD file, 2021-07-16]
CAD Files/PrusaSlicer/Print 1/entry_ramp.stl
53.0 x 95.5 x 86.0
