jawal19/3D-printing-a-mechanical-device/CAD Files/PrusaSlicer/Print 2/Gear_1A.stl

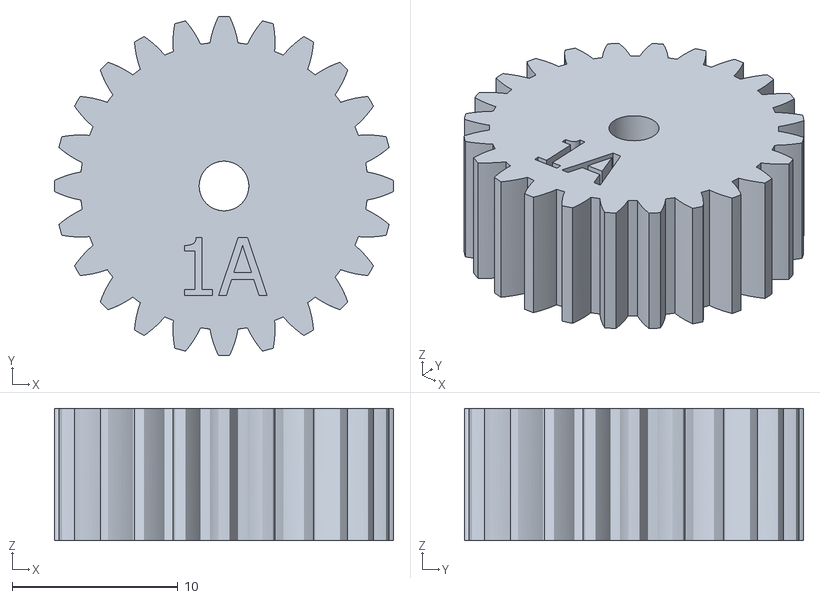
[picture p52: CAD file, 2021-07-16]
CAD Files/PrusaSlicer/Print 2/Gear_1A.stl
20.5 x 20.5 x 8.00
