jawal19/3D-printing-a-mechanical-device/CAD Files/PrusaSlicer/Print 1/Follower.stl

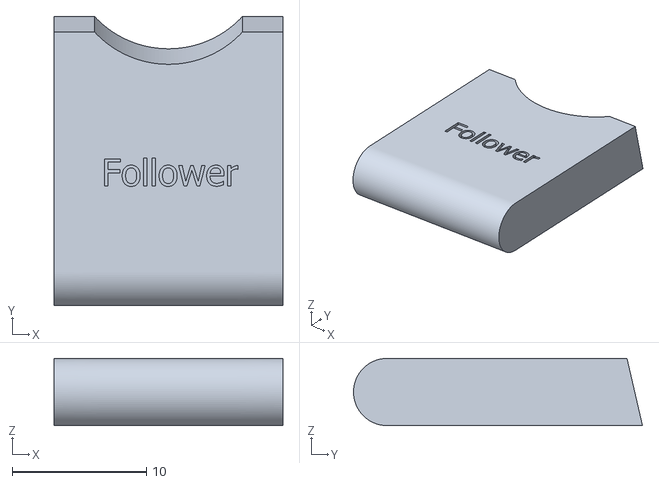
[picture p53: CAD file, 2021-07-16]
CAD Files/PrusaSlicer/Print 1/Follower.stl
17.0 x 21.5 x 5.00
