jawal19/3D-printing-a-mechanical-device/CAD Files/PrusaSlicer/Print 2/Support_1B.stl

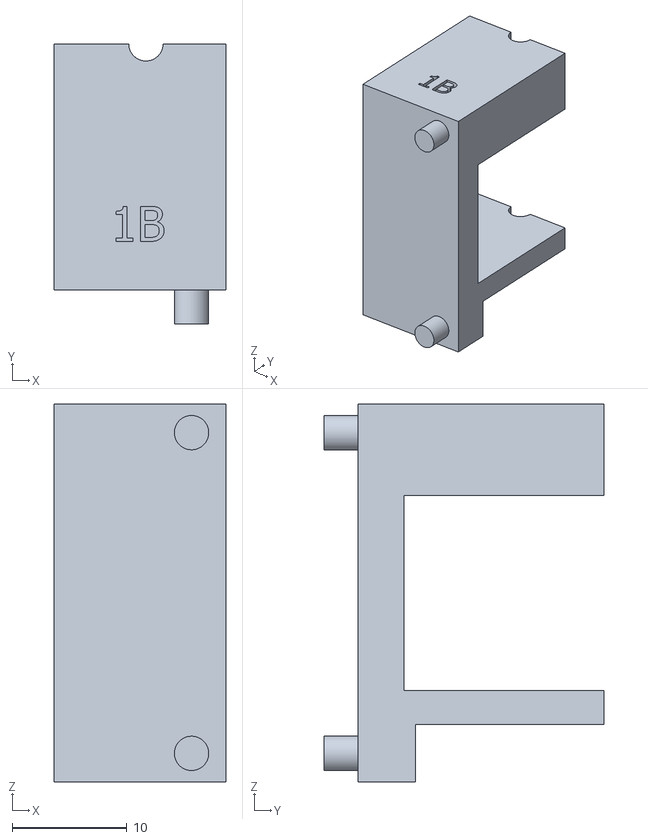
[picture p54: CAD file, 2021-07-16]
CAD Files/PrusaSlicer/Print 2/Support_1B.stl
15.0 x 24.5 x 33.0
