jawal19/3D-printing-a-mechanical-device/CAD Files/PrusaSlicer/Print 2/Gear_2B.stl

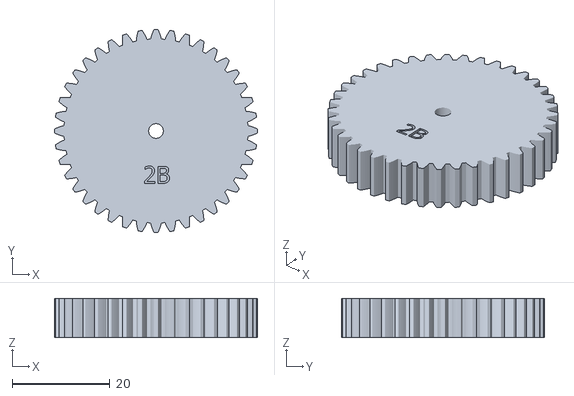
[picture p55: CAD file, 2021-07-16]
CAD Files/PrusaSlicer/Print 2/Gear_2B.stl
41.6 x 41.6 x 8.00
