jawal19/3D-printing-a-mechanical-device/(list of files, cad)

Other CAD files:
CAD Files/PrusaSlicer/Print 2/Follower.stl
CAD Files/Assemblies/Assembly `/Cam_4.ipt
CAD Files/Assemblies/Assembly `/Entry_ramp.ipt
CAD Files/Assemblies/Assembly `/Extra_Shaft.ipt
CAD Files/Assemblies/Assembly `/Input_Connection.ipt
CAD Files/Assemblies/Assembly `/OldVersions/Assembled_box.0025.iam
CAD Files/Assemblies/Assembly `/OldVersions/Block.0007.ipt
CAD Files/Assemblies/Assembly `/OldVersions/Cam_4.0004.ipt
CAD Files/Assemblies/Assembly `/OldVersions/Spur Gear15.0001.ipt
CAD Files/Assemblies/Assembly `/OldVersions/Spur_Gear12.0008.ipt
CAD Files/Assemblies/Assembly `/OldVersions/bottom_part.0002.ipt
CAD Files/Assemblies/Assembly `/OldVersions/shaft_support.0004.ipt
CAD Files/Assemblies/Assembly `/OldVersions/support_2.0004.ipt
CAD Files/Assemblies/Assembly `/OldVersions/top_part.0009.ipt
CAD Files/Assemblies/Assembly `/Ramp_Main.ipt
CAD Files/Assemblies/Assembly `/Shaft_2.ipt
CAD Files/Assemblies/Assembly `/Spur_Gear12 cam.ipt
CAD Files/Assemblies/Assembly `/Spur_Gear12.ipt
CAD Files/Assemblies/Assembly `/Spur_Gears2.iam
CAD Files/Assemblies/Assembly `/Spur_Gears3.iam
CAD Files/Assemblies/Assembly `/shaft_support.ipt
CAD Files/Assemblies/Assembly `/steel_rod.ipt
CAD Files/Assemblies/Assembly `/support_2.ipt
CAD Files/Assemblies/Main 2/SPOILER_Assembly_Folder/Assembly Folder/Assembled_box.iam
CAD Files/Assemblies/Main 2/SPOILER_Assembly_Folder/Assembly Folder/Block.ipt
CAD Files/Assemblies/Main 2/SPOILER_Assembly_Folder/Assembly Folder/Box_base.ipt
CAD Files/Assemblies/Main 2/SPOILER_Assembly_Folder/Assembly Folder/Box_side_1.ipt
CAD Files/Assemblies/Main 2/SPOILER_Assembly_Folder/Assembly Folder/Box_side_2.ipt
CAD Files/Assemblies/Main 2/SPOILER_Assembly_Folder/Assembly Folder/Box_side_3.ipt
CAD Files/Assemblies/Main 2/SPOILER_Assembly_Folder/Assembly Folder/Box_side_4.ipt
CAD Files/Assemblies/Main 2/SPOILER_Assembly_Folder/Assembly Folder/Box_top.ipt
CAD Files/Assemblies/Main 2/SPOILER_Assembly_Folder/Assembly Folder/Cam.ipt
CAD Files/Assemblies/Main 2/SPOILER_Assembly_Folder/Assembly Folder/Driveshaft_coupling_end.ipt
CAD Files/Assemblies/Main 2/SPOILER_Assembly_Folder/Assembly Folder/Follower.ipt
CAD Files/Assemblies/Main 2/SPOILER_Assembly_Folder/Assembly Folder/Input Connection.ipt
CAD Files/Assemblies/Main 2/SPOILER_Assembly_Folder/Assembly Folder/OVAAAAAL cam.ipt
CAD Files/Assemblies/Main 2/SPOILER_Assembly_Folder/Assembly Folder/OldVersions/Assembled_box.0035.iam
CAD Files/Assemblies/Main 2/SPOILER_Assembly_Folder/Assembly Folder/OldVersions/OVAAAAAL cam.0003.ipt
CAD Files/Assemblies/Main 2/SPOILER_Assembly_Folder/Assembly Folder/OldVersions/Shaft_1.0003.ipt
CAD Files/Assemblies/Main 2/SPOILER_Assembly_Folder/Assembly Folder/OldVersions/Shaft_2.0003.ipt
CAD Files/Assemblies/Main 2/SPOILER_Assembly_Folder/Assembly Folder/OldVersions/Spur Gear11.0004.ipt
CAD Files/Assemblies/Main 2/SPOILER_Assembly_Folder/Assembly Folder/OldVersions/Spur Gear15.0003.ipt
CAD Files/Assemblies/Main 2/SPOILER_Assembly_Folder/Assembly Folder/OldVersions/Spur Gear21.0003.ipt
CAD Files/Assemblies/Main 2/SPOILER_Assembly_Folder/Assembly Folder/OldVersions/Spur Gear25.0002.ipt
CAD Files/Assemblies/Main 2/SPOILER_Assembly_Folder/Assembly Folder/OldVersions/Support_1A.0001.ipt
CAD Files/Assemblies/Main 2/SPOILER_Assembly_Folder/Assembly Folder/OldVersions/Support_1B.0002.ipt
CAD Files/Assemblies/Main 2/SPOILER_Assembly_Folder/Assembly Folder/OldVersions/Support_2A.0001.ipt
CAD Files/Assemblies/Main 2/SPOILER_Assembly_Folder/Assembly Folder/OldVersions/Support_2B.0002.ipt
CAD Files/Assemblies/Main 2/SPOILER_Assembly_Folder/Assembly Folder/Shaft_1.ipt
CAD Files/Assemblies/Main 2/SPOILER_Assembly_Folder/Assembly Folder/Shaft_2.ipt
CAD Files/Assemblies/Main 2/SPOILER_Assembly_Folder/Assembly Folder/Spur Gear11.ipt
CAD Files/Assemblies/Main 2/SPOILER_Assembly_Folder/Assembly Folder/Spur Gear15.ipt
CAD Files/Assemblies/Main 2/SPOILER_Assembly_Folder/Assembly Folder/Spur Gear21.ipt
CAD Files/Assemblies/Main 2/SPOILER_Assembly_Folder/Assembly Folder/Spur Gear25.ipt
CAD Files/Assemblies/Main 2/SPOILER_Assembly_Folder/Assembly Folder/Support_1A.ipt
CAD Files/Assemblies/Main 2/SPOILER_Assembly_Folder/Assembly Folder/Support_1B.ipt
CAD Files/Assemblies/Main 2/SPOILER_Assembly_Folder/Assembly Folder/Support_2A.ipt
CAD Files/Assemblies/Main 2/SPOILER_Assembly_Folder/Assembly Folder/Support_2B.ipt
CAD Files/Assemblies/Main 2/SPOILER_Assembly_Folder/Assembly Folder/bottom_part.ipt
CAD Files/Assemblies/Main 2/SPOILER_Assembly_Folder/Assembly Folder/entry_ramp.ipt
CAD Files/Assemblies/Main 2/SPOILER_Assembly_Folder/Assembly Folder/exit_ramp.ipt
CAD Files/Assemblies/Project_Cad_Files_export/Assemblies/Assembled box.iam
CAD Files/Assemblies/Project_Cad_Files_export/Assemblies/OldVersions/Assembled box.0007.iam
CAD Files/Assemblies/Project_Cad_Files_export/Assemblies/Part3.ipt
CAD Files/Assemblies/Zipped Assembly 4/Ball.ipt
CAD Files/Assemblies/Zipped Assembly 4/Block.ipt
CAD Files/Assemblies/Zipped Assembly 4/Box base.ipt
CAD Files/Assemblies/Zipped Assembly 4/Box side 1.ipt
CAD Files/Assemblies/Zipped Assembly 4/Box side 2.ipt
CAD Files/Assemblies/Zipped Assembly 4/Box side 4.ipt
CAD Files/Assemblies/Zipped Assembly 4/Box top.ipt
CAD Files/Assemblies/Zipped Assembly 4/Box_side_3.ipt
CAD Files/Assemblies/Zipped Assembly 4/Cam.ipt
CAD Files/Assemblies/Zipped Assembly 4/Driveshaft coupling end.ipt
CAD Files/Assemblies/Zipped Assembly 4/Extra Shaft.ipt
CAD Files/Assemblies/Zipped Assembly 4/Input Connection.ipt
CAD Files/Assemblies/Zipped Assembly 4/Shaft 2.ipt
CAD Files/Assemblies/Zipped Assembly 4/Spur Gear Large 2-1.ipt
CAD Files/Assemblies/Zipped Assembly 4/Spur Gear Large 4-1.ipt
CAD Files/Assemblies/Zipped Assembly 4/Spur Gear Small 2-1.ipt
CAD Files/Assemblies/Zipped Assembly 4/Spur Gear Small 4-1.ipt
CAD Files/Assemblies/Zipped Assembly 4/Support_1A.ipt
CAD Files/Assemblies/Zipped Assembly 4/Support_1B.ipt
CAD Files/Assemblies/Zipped Assembly 4/Support_2A.ipt
CAD Files/Assemblies/Zipped Assembly 4/Support_2B.ipt
CAD Files/Assemblies/Zipped Assembly 4/Working Simlation and Assembly.iam
CAD Files/Assemblies/Zipped Assembly 4/bottom_part.ipt
CAD Files/Assemblies/Zipped Assembly 4/entry_ramp.ipt
CAD Files/Box/Assembled box.iam
CAD Files/Box/Box base.ipt
CAD Files/Box/Box side 1.ipt
CAD Files/Box/Box side 2.ipt
CAD Files/Box/Box side 3.ipt
CAD Files/Box/Box side 4.ipt
CAD Files/Box/Box top.ipt
CAD Files/Example/Example Follower.ipt
CAD Files/Example/Example Slider.ipt
CAD Files/Gear Train/Driveshaft coupling end (1).ipt
CAD Files/Gear Train/OldVersions/gear(1).0001.iam
CAD Files/Gear Train/OldVersions/gear.0001.iam
CAD Files/Gear Train/gear(1).iam
CAD Files/Gear Train/gear(1)/Design Accelerator/Spur Gear14.ipt
CAD Files/Gear Train/gear(1)/Design Accelerator/Spur Gear24.ipt
CAD Files/Gear Train/gear(1)/Design Accelerator/Spur Gears4.iam
CAD Files/Gear Train/gear.iam
CAD Files/Main/Main_Assembly_export/Assembled box.iam
CAD Files/Main/Main_Assembly_export/Box base.ipt
CAD Files/Main/Main_Assembly_export/Box side 1.ipt
CAD Files/Main/Main_Assembly_export/Box side 2.ipt
CAD Files/Main/Main_Assembly_export/Box side 3.ipt
CAD Files/Main/Main_Assembly_export/Box side 4.ipt
CAD Files/Main/Main_Assembly_export/Box top.ipt
CAD Files/Main/Main_Assembly_export/Driveshaft coupling end.ipt
CAD Files/Main/Main_Assembly_export/Extra Shaft.ipt
CAD Files/Main/Main_Assembly_export/Final Spur Gear Large.ipt
CAD Files/Main/Main_Assembly_export/Follower Ramp.ipt
CAD Files/Main/Main_Assembly_export/Input Connection.ipt
CAD Files/Main/Main_Assembly_export/OldVersions/Assembled box.0002.iam
CAD Files/Main/Main_Assembly_export/OldVersions/Final Spur Gear Large.0007.ipt
CAD Files/Main/Main_Assembly_export/OldVersions/Spur Gear12.0006.ipt
CAD Files/Main/Main_Assembly_export/Pear cam 2.ipt
CAD Files/Main/Main_Assembly_export/Shaft 2.ipt
CAD Files/Main/Main_Assembly_export/Spur Gear12.ipt
CAD Files/Main/Main_Assembly_export/bottom_part.ipt
CAD Files/Main/Main_Assembly_export/gear.iam
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
