jawal19/3D-printing-a-mechanical-device/Submision 1/Assembly Instructions.pdf

# Assembly Instructions

Group 14

## Parts

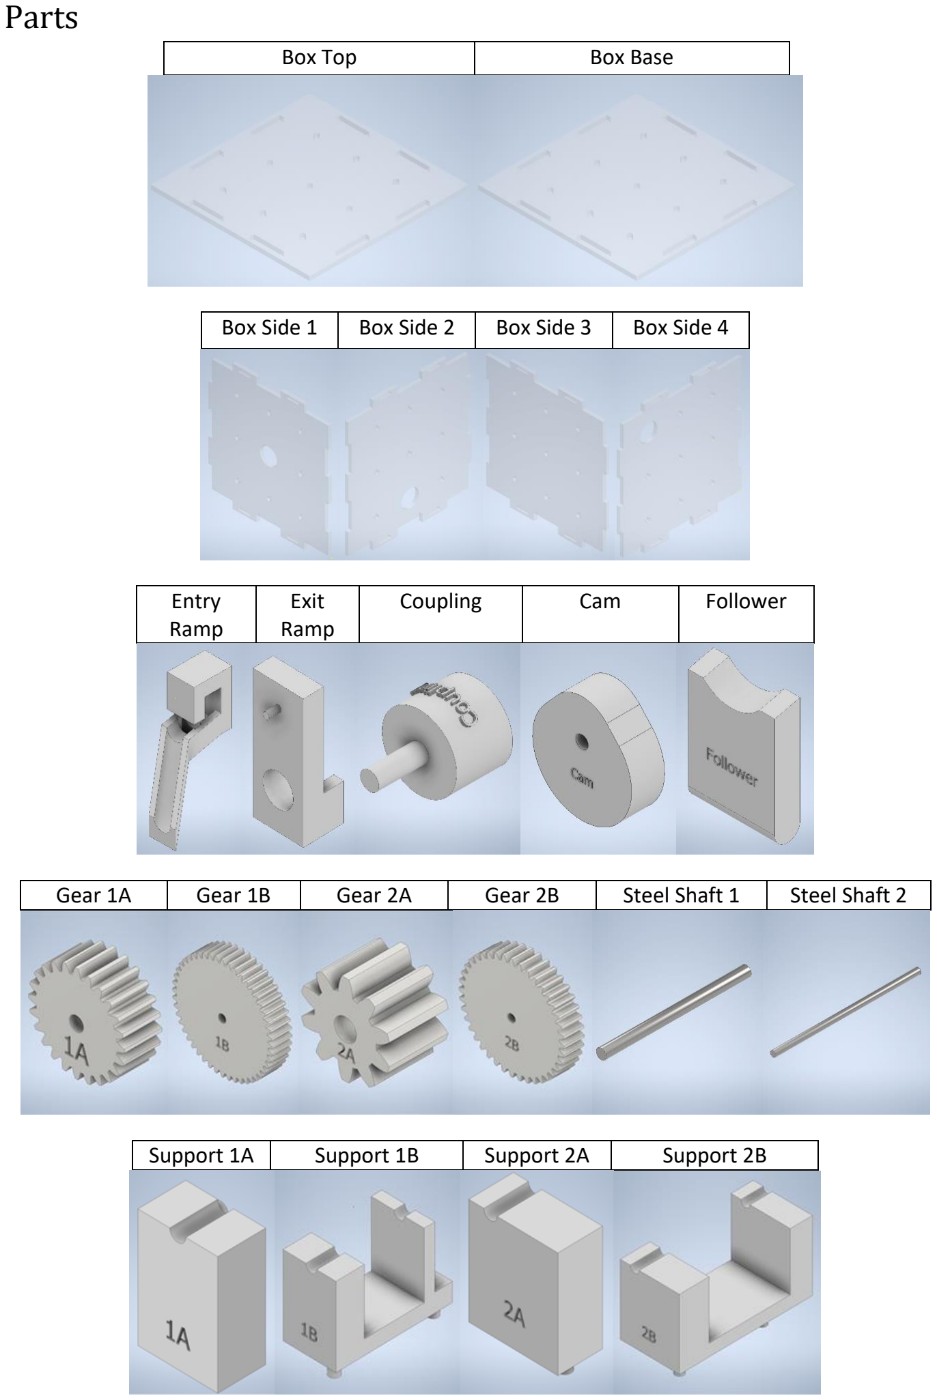
[picture p56: page 2]

Box Top | Box Base
Box Side 1 | Box Side 2 | Box Side 3 | Box Side 4

Entry
Ramp

Exit
Ramp
Coupling | Cam | Follower
Gear 1A | Gear 1B | Gear 2A | Gear 2B | Steel Shaft 1 | Steel Shaft 2
Support 1A | Support 1B | Support 2A | Support 2B

### Step 1: Appl

### y Glue to

Entry Ramp Using the Entry Ramp

apply glue to the red
shaded area shown in
Figure

1

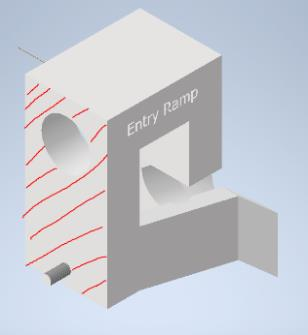
[picture p57: figure]

Figure

1

### Step 2: Attach

i

n

g
Entry Ramp Slot the protruding

cylinder from Entry Ramp
into the hole of B

o

x Side
4 indicated by the RED
arrow in Figure

2

. Ensure
the two large holes align
as shown by the BLACK
arrow and set the part

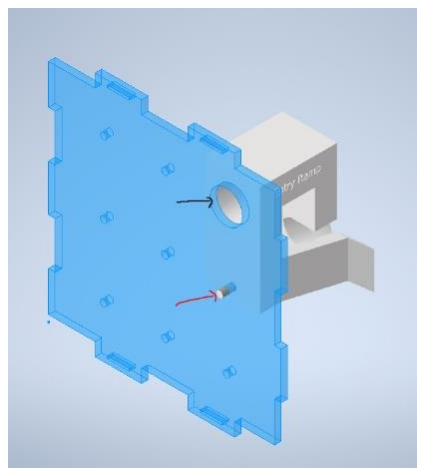
[picture p58: figure]

aside as shown in Figure 3 | Figure

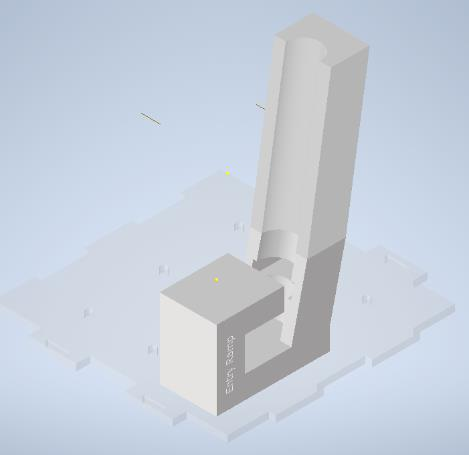
[picture p59: figure]

2 | Figure

3

### Step

### 3: Apply Glue to Exit Ramp

Using the Exit Ramp,
apply glue to the shaded
area shown in Figure

4

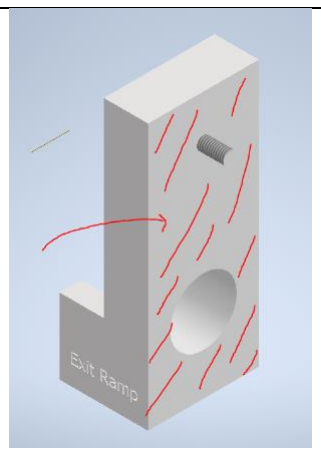
[picture p60: figure]

Figure

4

### Step 4: Attaching

Exit Ramp Slot the protruding

cylinder from

Exit Ramp
into the hole of B

o

x Side
2 indicated by the RED
arrow in Figure

5

. Ensure
the two large holes align
as shown by the BLACK
arrow and set the part
aside as shown in Figure 6.

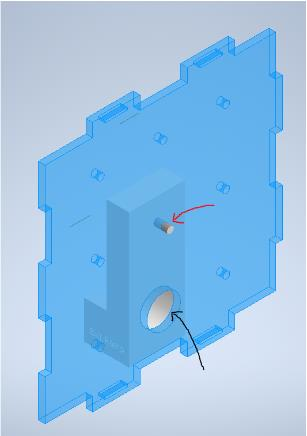
[picture p61: figure]

Figure

5

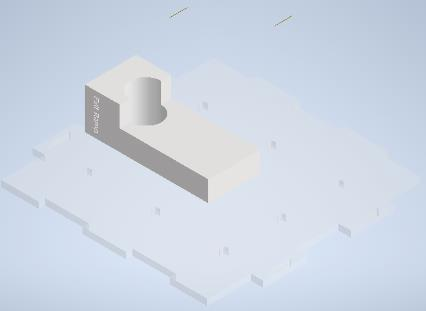
[picture p62: figure]

Figure

6

### Step 5: Attaching Support 1A

Insert the protruded
cylinder of Support 1A
into the hole of Box Side 1, as shown by the BLACK

arrow in Figure

7. Ensure
the teeth of Box Side 4
are match the BLUE
circle

. The two parts
should match Figure

8

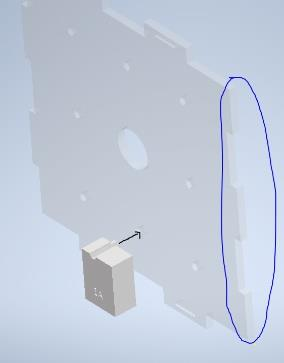
[picture p63: figure]

Figure

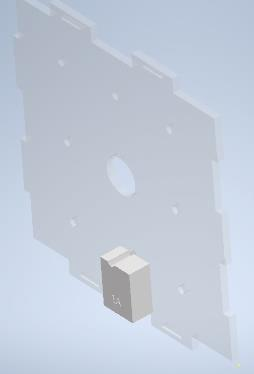
[picture p64: figure]

7 | Figure
8

### Step 6: Attaching Support 1B

Insert the protruded
cylinder

s of Support 1B
into the second row of
holes in the

Base Plate as
shown in Figure

9 and
Figure 10. The result
should match Figure 11
Note: If the protruded
cylinders don’t align with the holes on the

Base
Plate, ro

tate the Base
Plate 90

°.

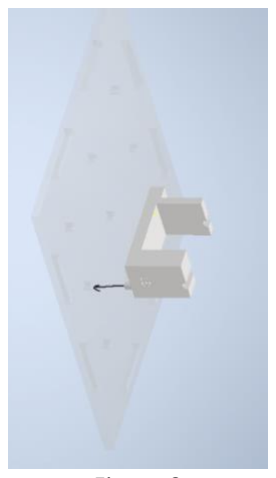
[picture p65: figure]

Figure

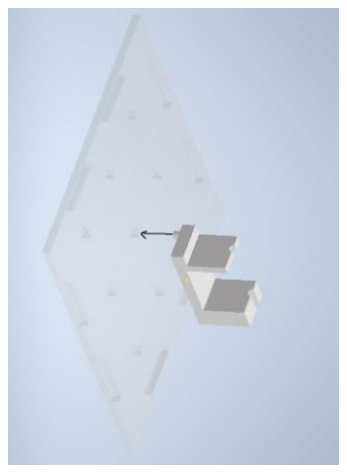
[picture p66: figure]
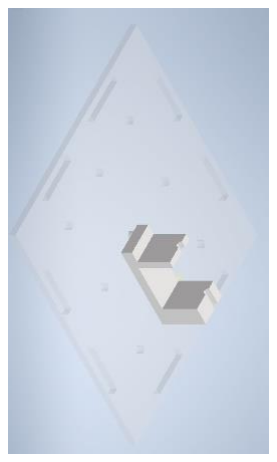
[picture p67: figure]

9 | Figure 10 | Figure 11

### Step 7: Attaching Support 2

A
Insert the protruded
cylinder of Support 2A
into the hole of the Base
Plate as shown in Figure
12. Ensure Support 2A is
on the LEFT side of
Support 1B. The result
should match Figure 13.

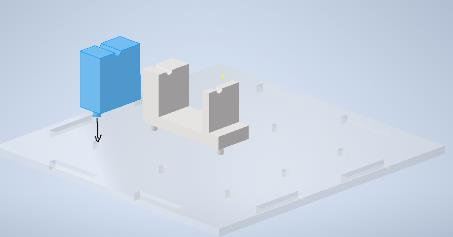
[picture p68: figure]

Figure 12

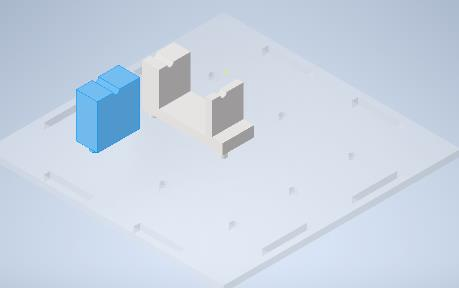
[picture p69: figure]

Figure 13

### Step 8: Attaching Support 2B

Insert the protruded
cylinders of

Support 2B
into the holes of the Base plate as shown in Figure
14

. The result should
match Figure 15

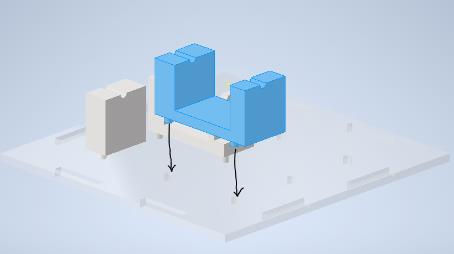
[picture p70: figure]

Figure 14

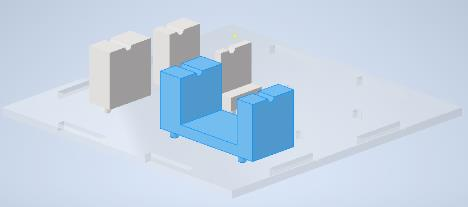
[picture p71: figure]

Figure 15

### Step 9: Attaching Gear

2

A
Insert Gear 2A into St

eel
Shaft 1 (smaller one of
the two

) as shown in
Figure 16

. Measure
6.5mm from either end
and apply

glue to the RED
area shown by the arrow
in Figure 17

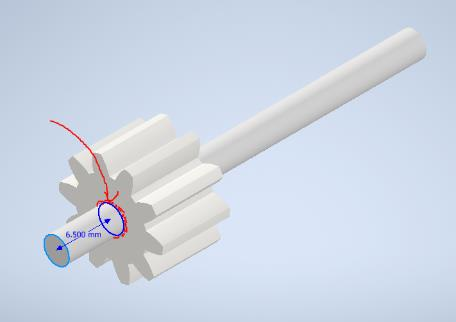
[picture p72: figure]
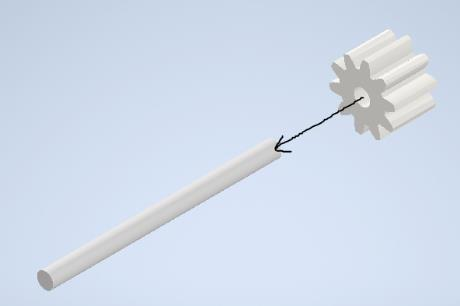
[picture p73: figure]

Figure 16 | Figure 17

### Step 10: Attaching Gear 1B

Insert Gear 1B onto the
same s

haft from Step 9:
Attaching Gear

2

A as
shown in Figure 18.
Measure 6mm from the
other end and apply glue
to the RED are shown by

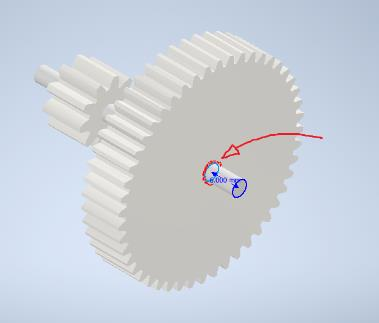
[picture p74: figure]
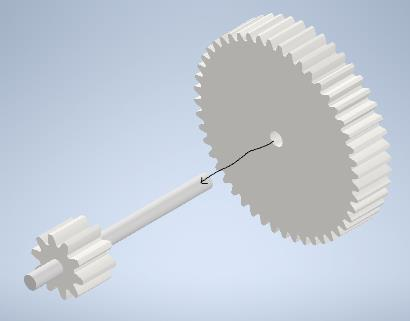
[picture p75: figure]

the arrow in Figure 19 | Figure 18 | Figure 19

### Step 11: Attaching Gear 2B

Insert Gear 2B into Steel
Shaft 2 (larger one of the tw

o

) as shown in Figure
20. Measure 16mm from either end and apply glue

to the RED area shown by
the

arrow in Figure 21

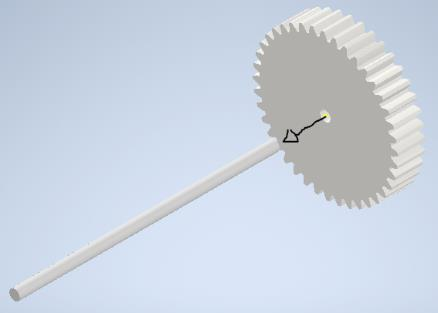
[picture p76: figure]
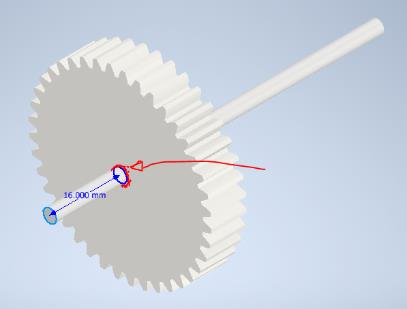
[picture p77: figure]

Figure 20 | Figure 21

### Step 12: Attaching the Cam

Insert the Cam into the
same shaft from Step 11: Attaching Gear 2B as

shown in Figure 22.
Measure 9.5mm from the
other end and apply glue
to the RED area shown by
the arrow in Figure 23

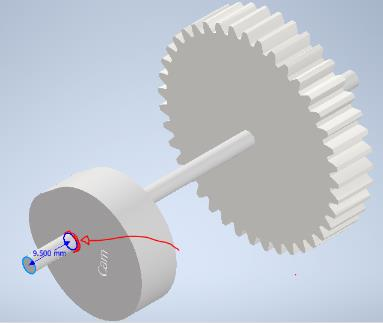
[picture p78: figure]
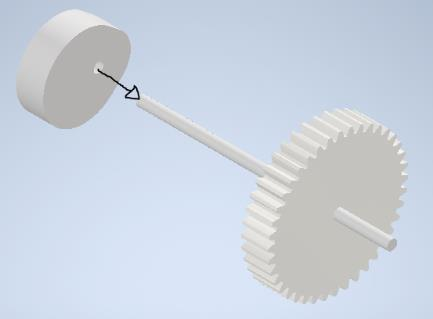
[picture p79: figure]

Figure 22 | Figure 23

### Step 13: Attaching Gear 1A

Apply glue to the RED
shade area of Coupling
Figure 24. Insert the shaft into Gear 1A as shown in
Figure 25. Let the glue

set
as shown by Figure

2

6

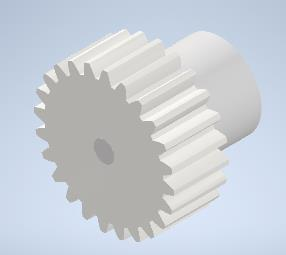
[picture p80: figure]
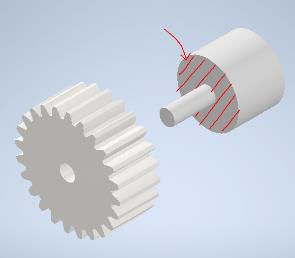
[picture p81: figure]

Figure 24 | Figure 25 | Figure

2

6

### Step 14: Combining the Box Side 1

Insert the teeth of Box
Side 1 into slots of Box
Base as shown by the
BLACK arrows in Figure
27. The result should
match Figure 28

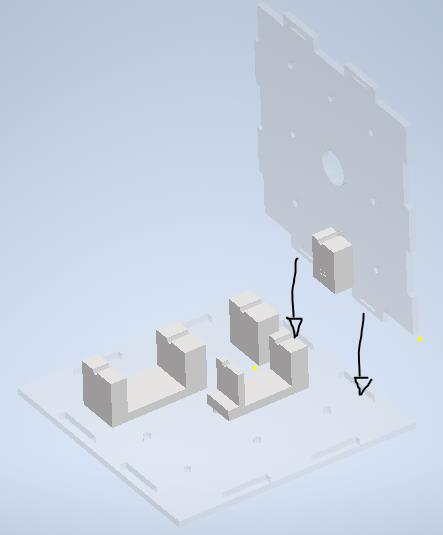
[picture p82: figure]
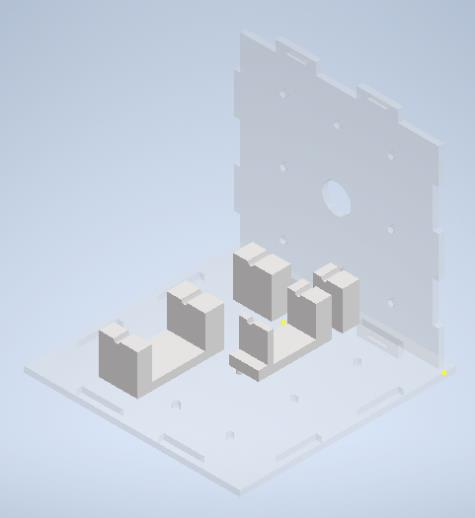
[picture p83: figure]

Figure 27 | Figure 28

### Step 15: Placing Steel Rod 1 & 2

Place assembled Steel
Shaft 1 from Step 10:
Attaching Gear 1B onto
the groove

s of Supports
1A and 1B as orientated
in Figure 29. Similarly
Place assembled Steel
Shaft 2 from Step 12:
Attaching the C

a

m onto
the grooves of Supports
2A and 2B as orientated
in Figure 30

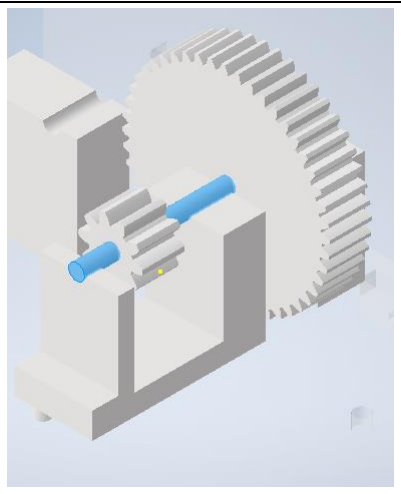
[picture p84: figure]

. | Figure 29

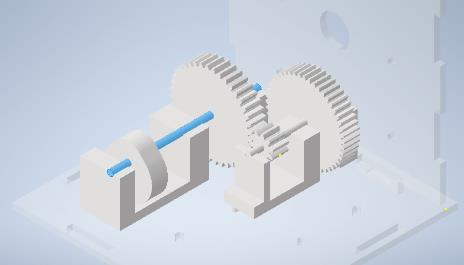
[picture p85: figure]

Figure 30

### Step 16: Attaching Gear 1A to the Inpu

t
Place

and hold the
assembly of Gear 1A
from Step 13: Attaching
Gear 1A onto Gear 1B so
that they mesh together
as shown in

Figure 31.
Whilst

holding, take the
input of your choice and
pass it through the hole
of Box Side 1 and connect
with the assembly of
Gear 1A as shown in
Figure 32.

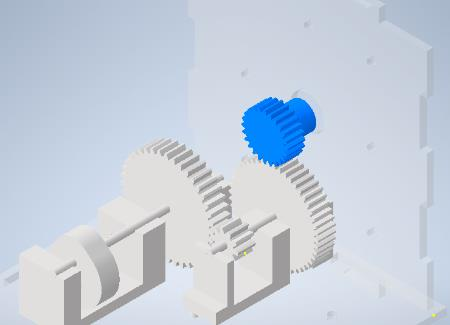
[picture p86: figure]
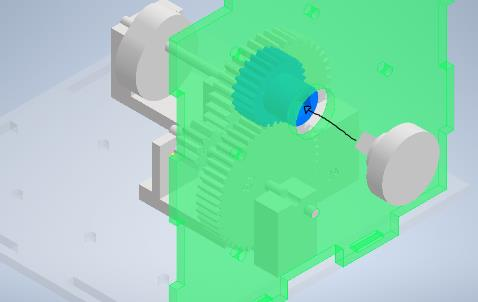
[picture p87: figure]

Figure 31 | Figure 32

### Step 17: Combining Box Side 2

Insert the teeth of Box
Side 2 into the slot of Box Base as shown by the BLACK arrows in Figure
33. Ensure the teeth and
slots circled in RED are
aligned properly. The
result should match
Figure 34

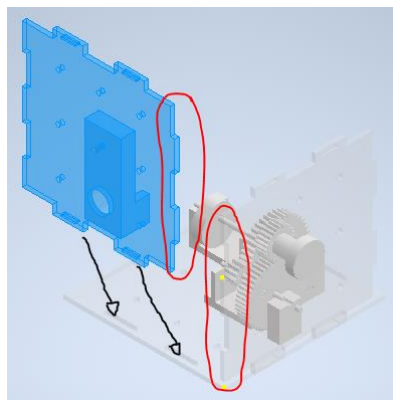
[picture p88: figure]
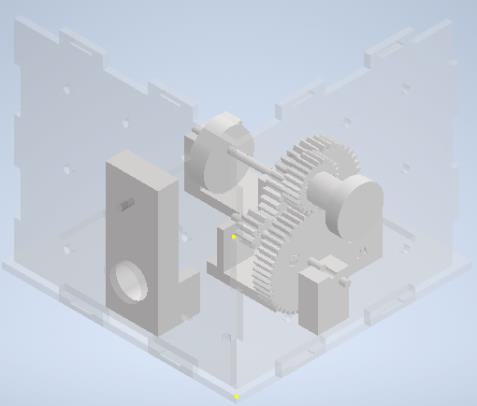
[picture p89: figure]

. | Figure 33 | Figure 34

### Step 18: Inserting the Follower

Insert the Follower into
the

assembly of Entry
Ramp from Step 2:
Attach

i

n

g Entry Ramp as
shown in Figure 35.

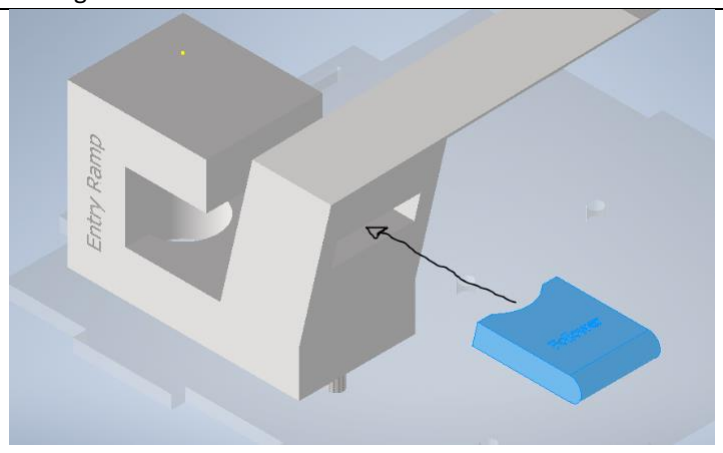
[picture p90: figure]

Figure 35

### Step 19: Combining Box Side

4
Hold the Cam shown in
red in Figure 36 with yo

ur
thumb so it doesn’t fall
out, and slot the teeth of Box Side 4 into the Box
Base as shown in Figure
37. Ensure the teeth
circled in RED are aligned properly. The res

ult
should match Figure 38
with the Entry and Exit
Ramp aligning with each other.

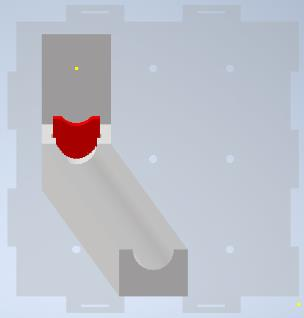
[picture p91: figure]
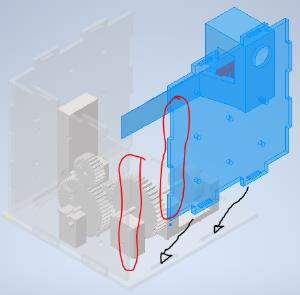
[picture p92: figure]

Figure 36 | Figure 37

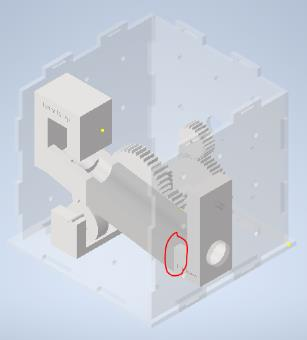
[picture p93: figure]

Figure 38

### Step 20: Combining Box Side 3 and Box Top

Insert the teeth of Box
Side 3 into the

B

o

x Base
as shown by the BLACK
arrows in Figure 39.
Ensure the teeth
encircled in RED align
properly. Similarly Insert the teeth of Box Top into
the other 4 Box sides as
shown in Figure 40

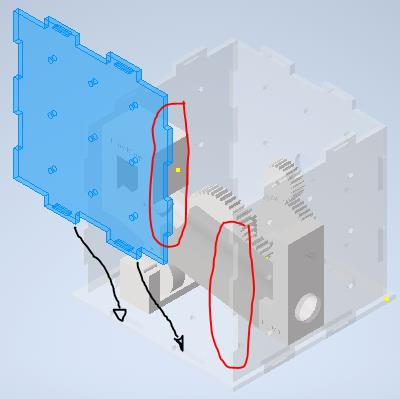
[picture p94: figure]

Figure 39

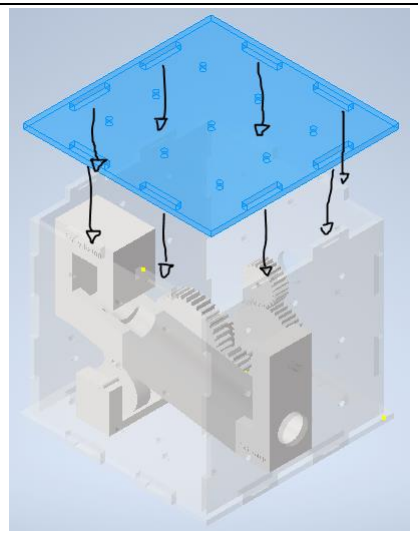
[picture p95: figure]

Figure 40

### There you have it, the complete Box!

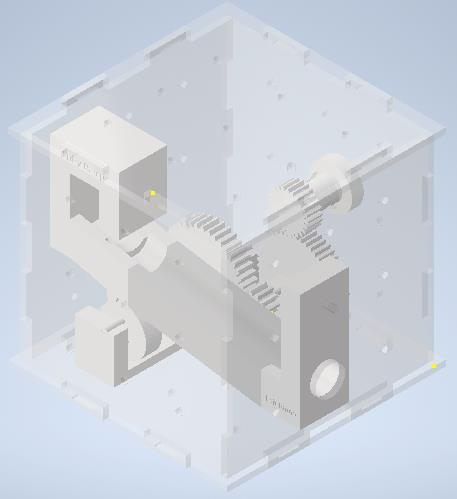
[picture p96: figure]
