jawal19/3D-printing-a-mechanical-device/Assembly Instructions/Box/Box3.PNG

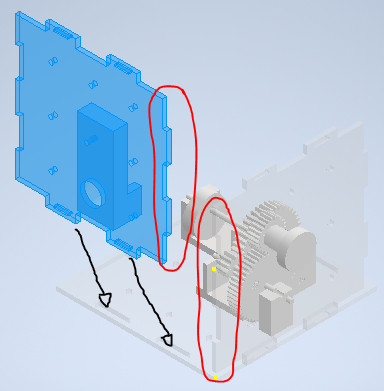
Assembly Instructions/Box/Box3.PNG
