jawal19/3D-printing-a-mechanical-device/Assembly Instructions/Box/Box9.PNG

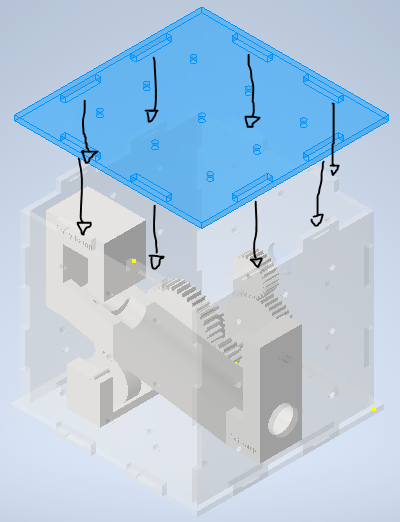
Assembly Instructions/Box/Box9.PNG
