jawal19/3D-printing-a-mechanical-device/Assembly Instructions/follower/Follower.PNG

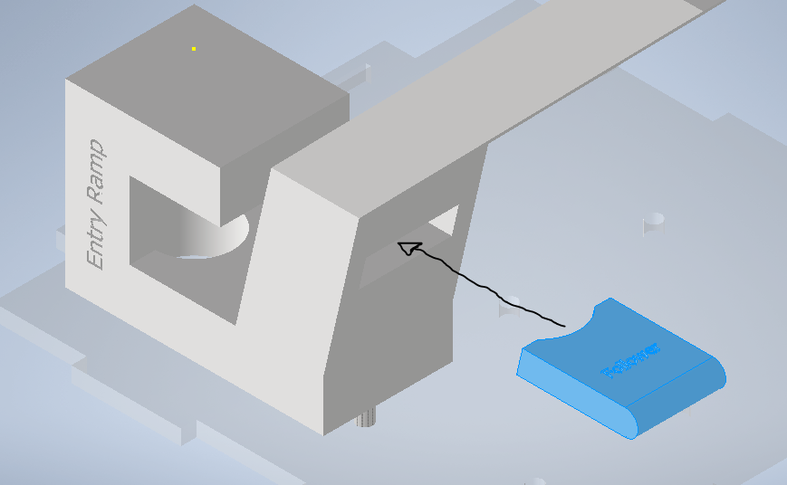
Assembly Instructions/follower/Follower.PNG
