jawal19/3D-printing-a-mechanical-device/Assembly Instructions/Gears/Gears 3.PNG

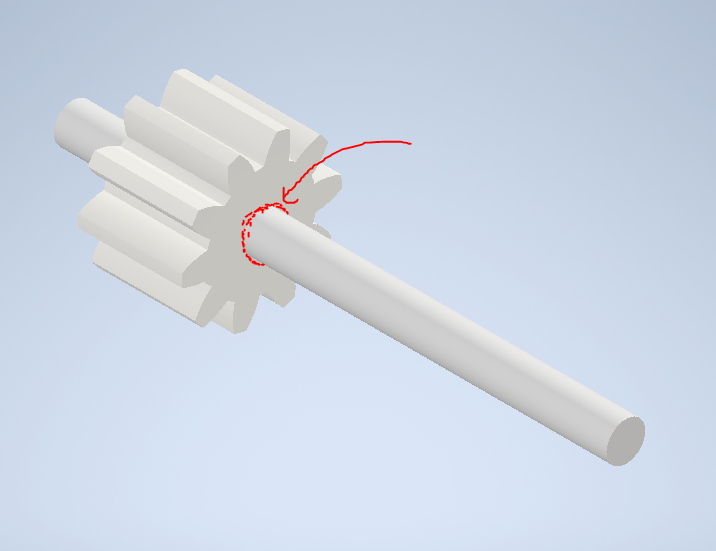
Assembly Instructions/Gears/Gears 3.PNG
