jawal19/3D-printing-a-mechanical-device/Assembly Instructions/Gears/Gears 6.PNG

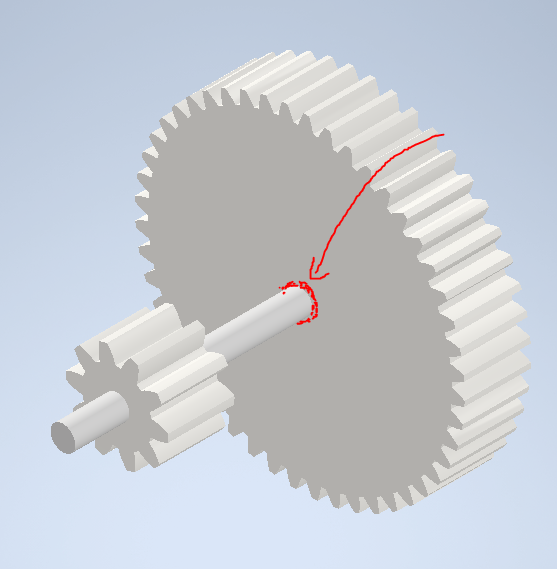
Assembly Instructions/Gears/Gears 6.PNG
