jawal19/3D-printing-a-mechanical-device/Assembly Instructions/Shafts/Shaft 1.PNG

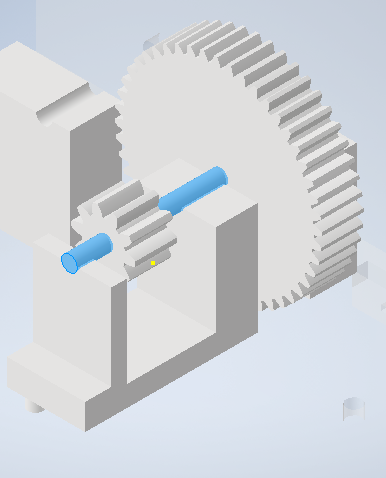
Assembly Instructions/Shafts/Shaft 1.PNG
