jawal19/3D-printing-a-mechanical-device/Assembly Instructions/Supports/Support 1A-2.PNG

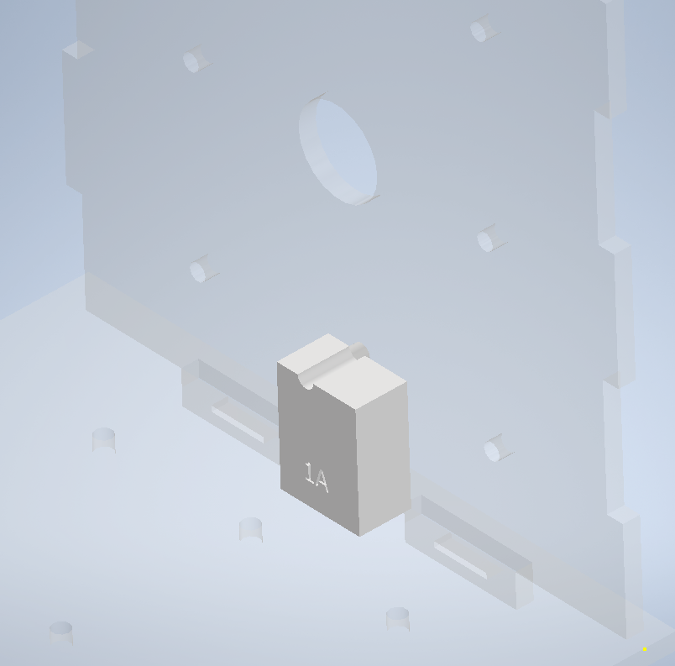
Assembly Instructions/Supports/Support 1A-2.PNG
