jawal19/3D-printing-a-mechanical-device/Assembly Instructions/Supports/Support 1B.PNG

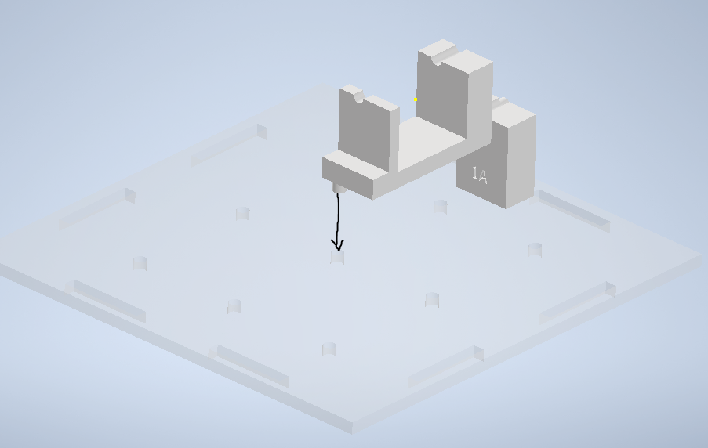
Assembly Instructions/Supports/Support 1B.PNG
