jawal19/3D-printing-a-mechanical-device/Assembly Instructions/Supports/Support 2A.PNG

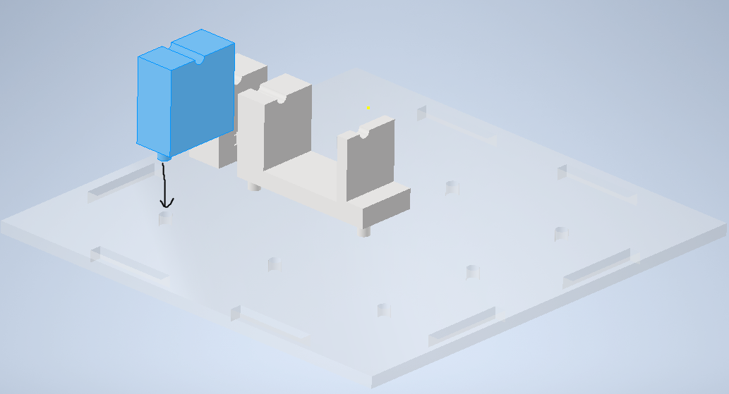
Assembly Instructions/Supports/Support 2A.PNG
