jawal19/3D-printing-a-mechanical-device/Assembly Instructions/Supports/Support 2B.PNG

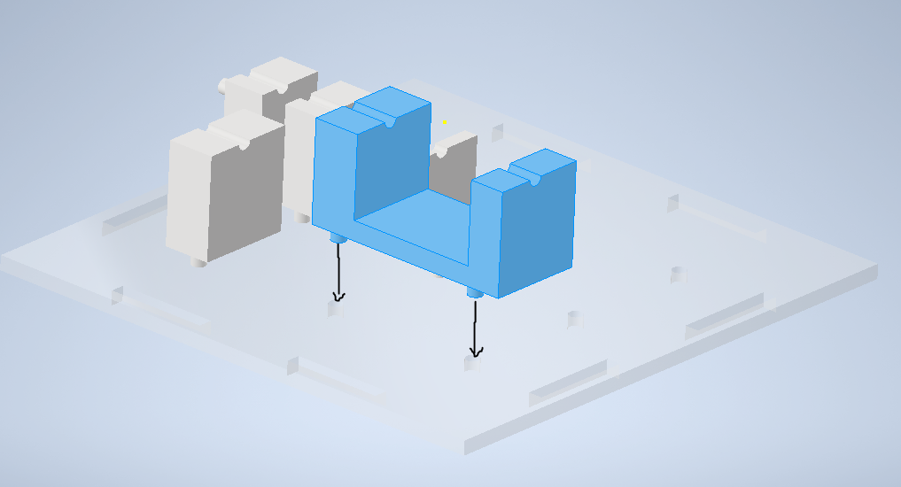
Assembly Instructions/Supports/Support 2B.PNG
