jawal19/3D-printing-a-mechanical-device/Assembly Instructions/Supports/Supports 2.PNG

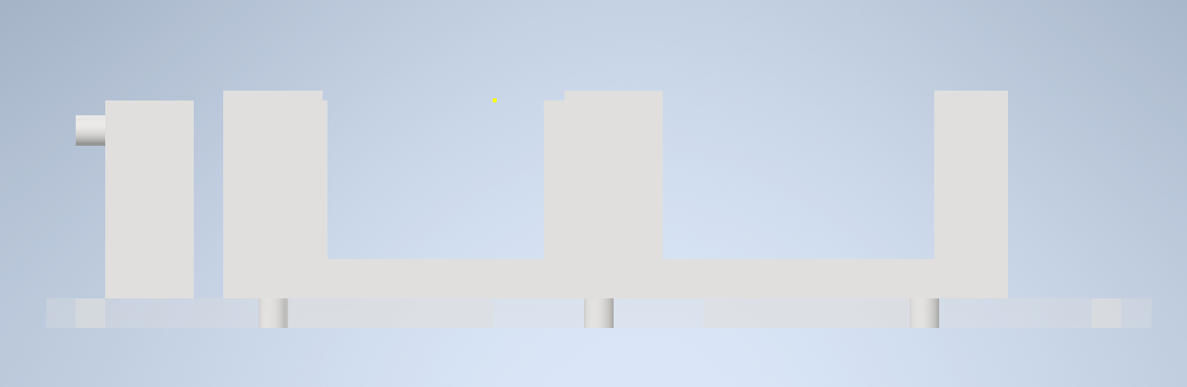
Assembly Instructions/Supports/Supports 2.PNG
