jawal19/3D-printing-a-mechanical-device/Assembly Instructions/Supports/Supports.PNG

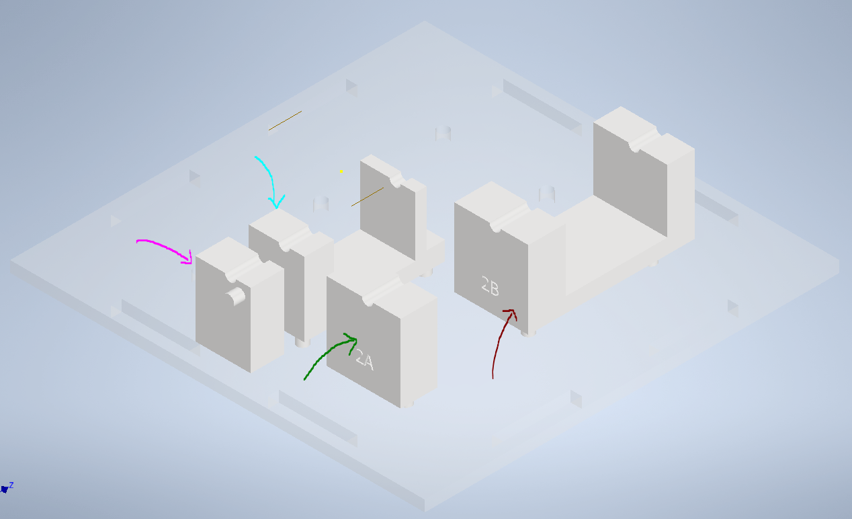
Assembly Instructions/Supports/Supports.PNG
