jawal19/3D-printing-a-mechanical-device/Report/Images/PrusaSlicer/Print_1.PNG

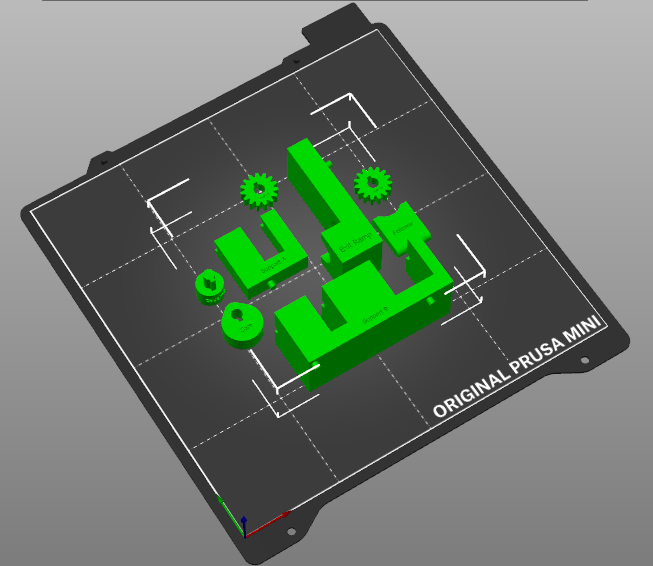
Report/Images/PrusaSlicer/Print_1.PNG
