jawal19/3D-printing-a-mechanical-device/Report/Images/PrusaSlicer/Print_2.PNG

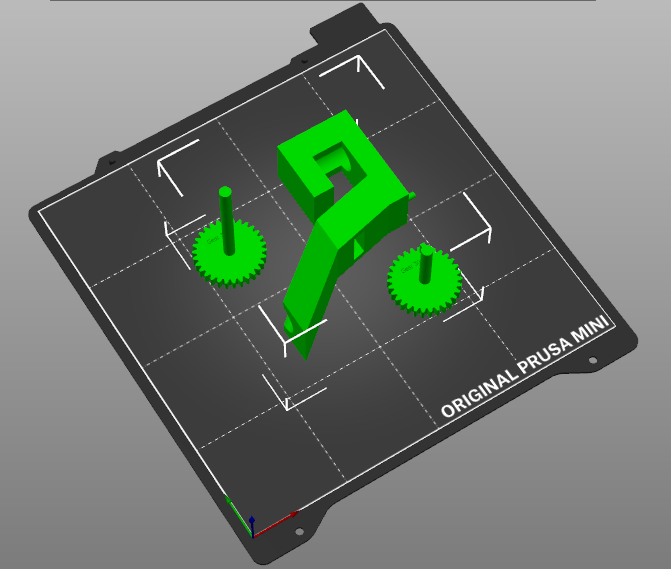
Report/Images/PrusaSlicer/Print_2.PNG
