jawal19/3D-printing-a-mechanical-device/Report/Images/PrusaSlicer/Print_3.PNG

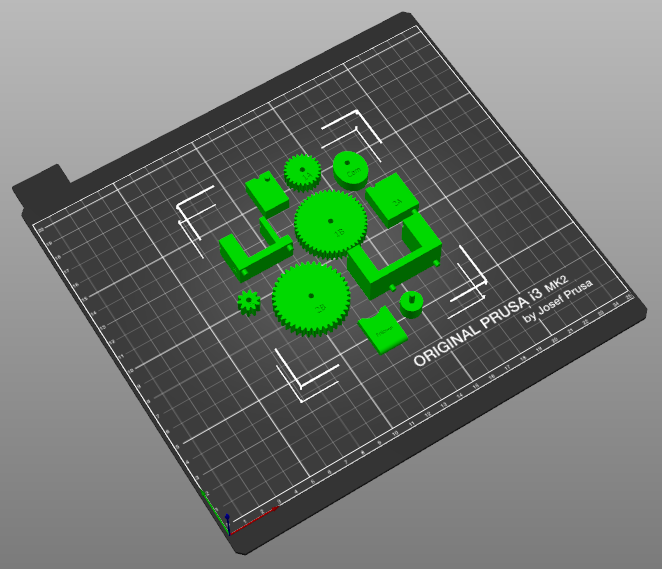
Report/Images/PrusaSlicer/Print_3.PNG
