jawal19/3D-printing-a-mechanical-device/(commit log)

2021-07-17 Main Project Files added
    [Ball.ipt, Block.ipt, Box base.ipt, Box side 1.ipt, Box side 2.ipt, Box side 4.ipt, Box top.ipt, Box_side_3.ipt]
2021-07-17 Assembly instructions added
